mlab-modules/DATALOGGER02/doc/gen/img/DATALOGGER02-bottom.png

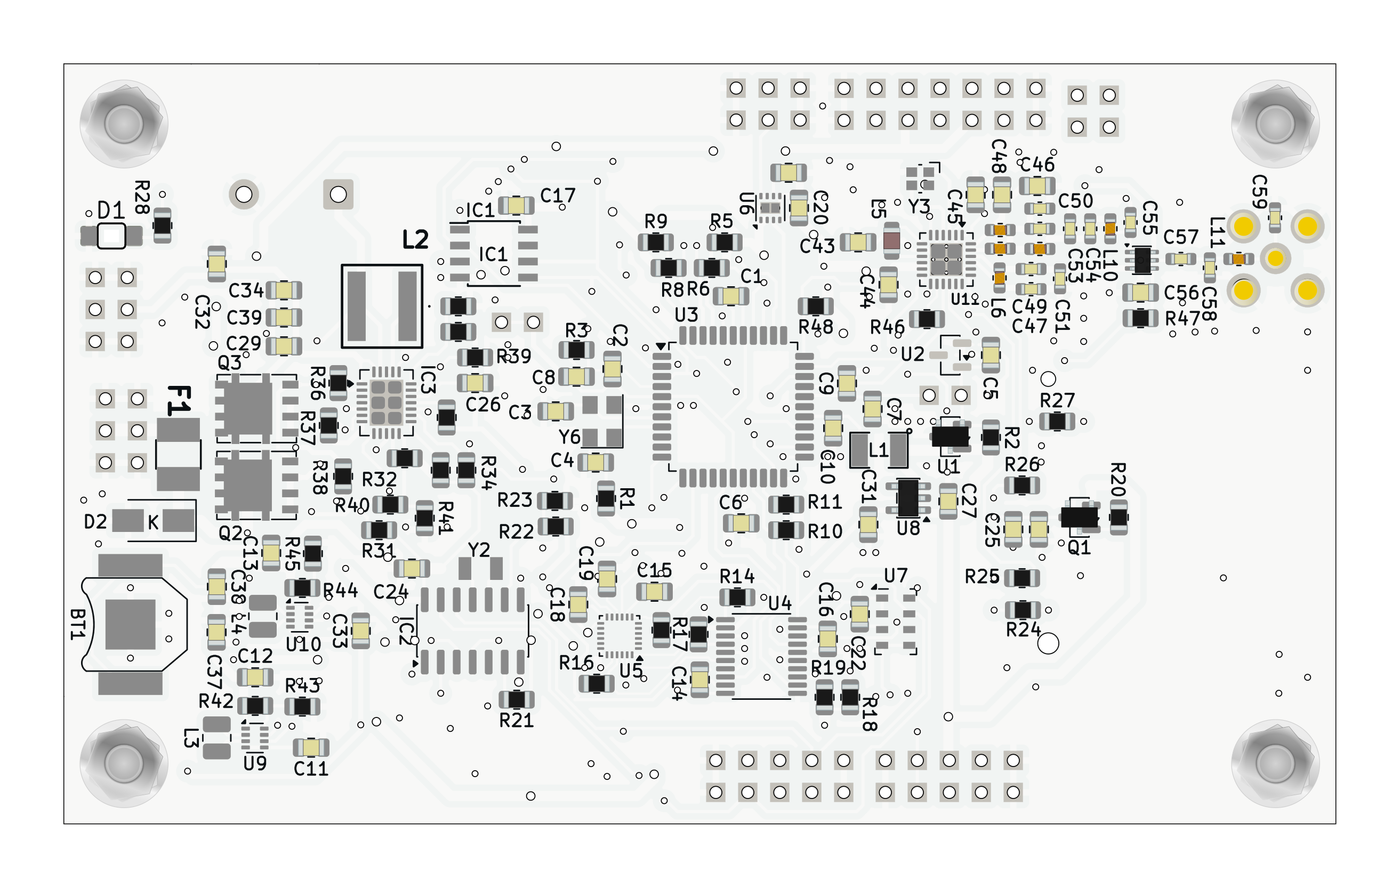
doc/gen/img/DATALOGGER02-bottom.png
