mlab-modules/DATALOGGER02/doc/gen/img/DATALOGGER02-top.png

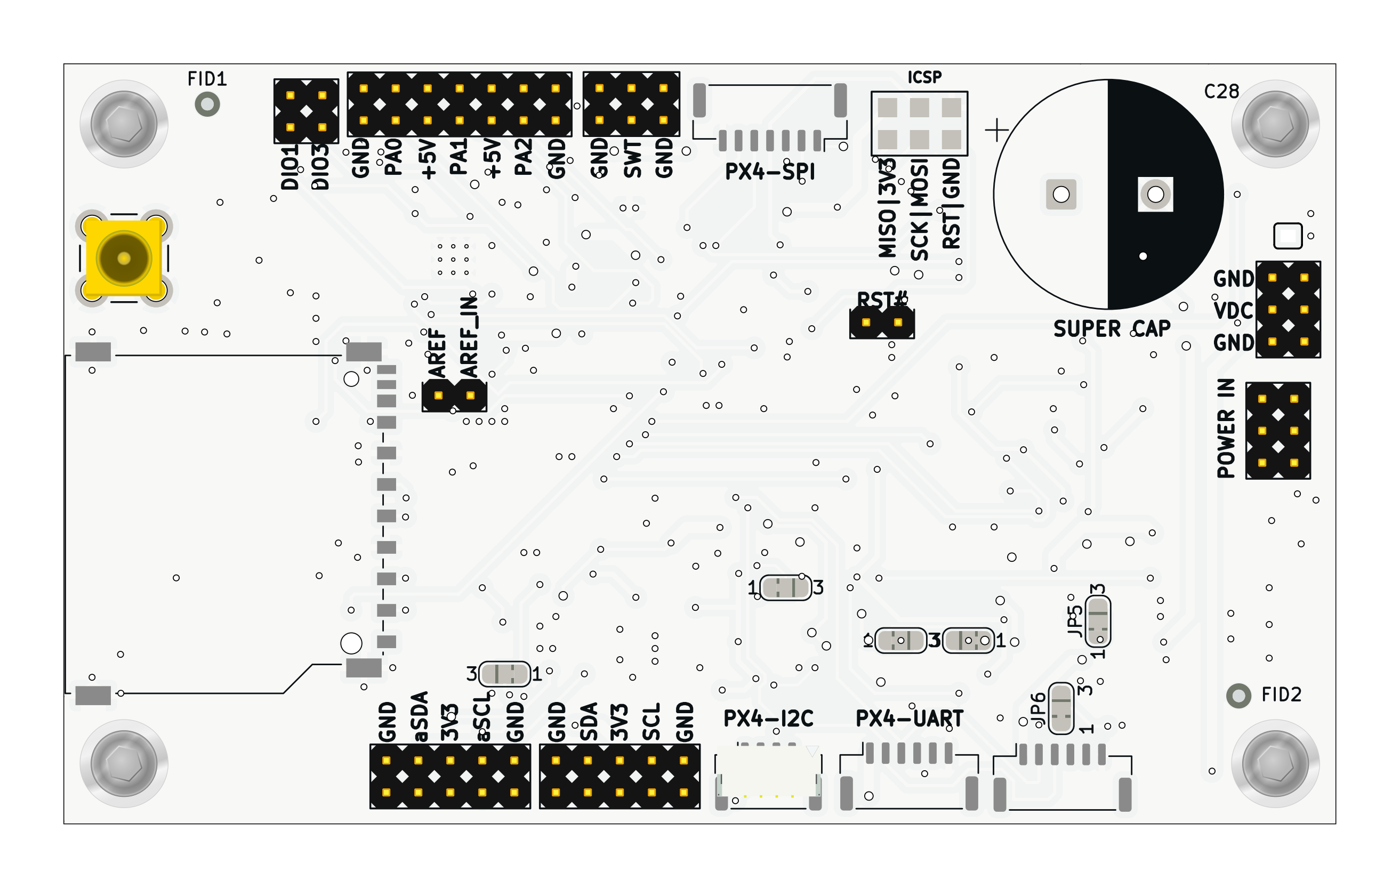
doc/gen/img/DATALOGGER02-top.png
