mlab-modules/DATALOGGER02/doc/gen/DATALOGGER02.step

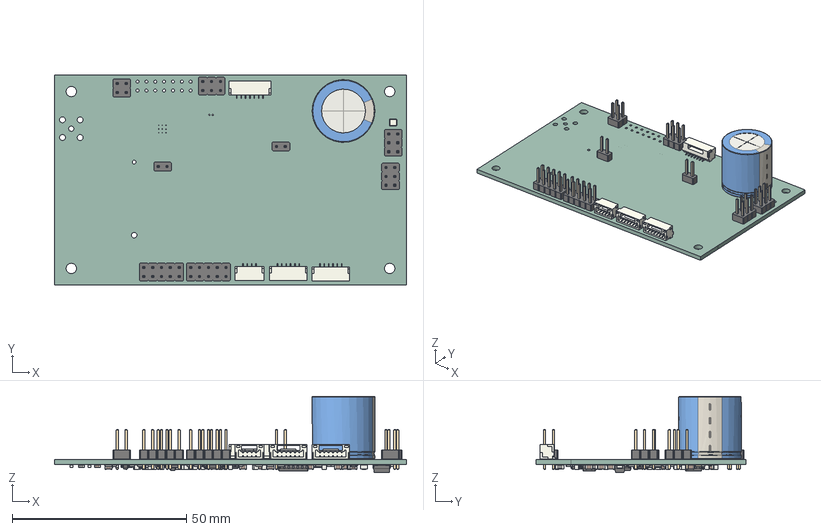
[picture p3: CAD file, 2026-08-09]
doc/gen/DATALOGGER02.step
101.1 x 60.5 x 21.9 mm
PinHeader_2x03_P254mm_Vertical x 3
PinHeader_2x05_P254mm_Vertical x 2
CP_Radial_D180mm_P750mm
JST_SM04B_GHS_TB
JST_SM06B_GHS_TB x 2
PinHeader_2x01_P254mm_Vertical x 2
PinHeader_2x02_P254mm_Vertical
JST_SM07B_GHS_TB
R_0805_2012Metric x 44
C_0805_2012Metric x 41
SOIC-14_3.9x8.7mm_P1.27mm
C_0603_1608Metric x 11
L_0603_1608Metric x 6
QFN-24-1EP_4x4mm_Pitch0.5mm
SOT-363_SC-70-6
SOT-583-8 x 2
TSSOP-20_4.4x6.5mm_P0.65mm
SOT-23 x 2
LED_1206_3216Metric
QFN-24-1EP_4x5mm_Pitch0.5mm
SOT-23-5
WSON_8_1EP_2x2mm_P05mm_EP09x16mm
LGA_8_3x5mm_P125mm
L_0805_2012Metric
L_1008_2520Metric x 2
TQFP-44_10x10mm_P0.8mm
SOIC-8_3.9x4.9mm_P1.27mm
D_SMA
kibot_2kaa3o_s_PCB
