mlab-modules/DATALOGGER02/doc/gen/dxf/DATALOGGER02-Edge_Cuts.dxf

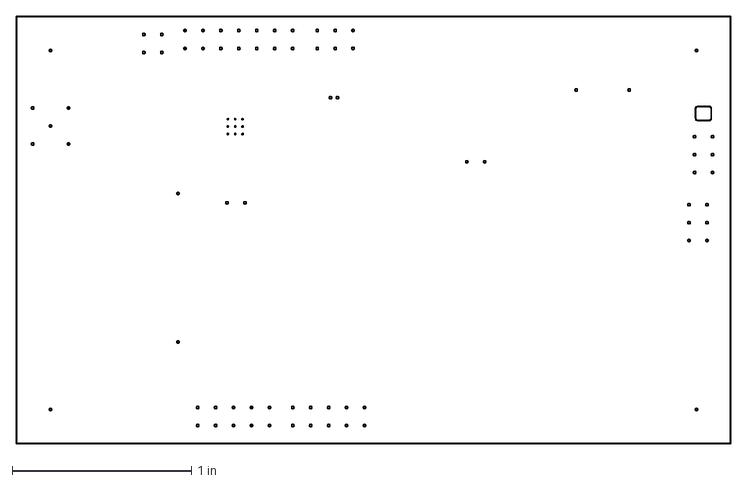
[picture p4: CAD file, 2026-08-09]
doc/gen/dxf/DATALOGGER02-Edge_Cuts.dxf
3.98 x 2.38 in
