mlab-modules/DATALOGGER02/doc/gen/dxf/DATALOGGER02-B_Fab.dxf

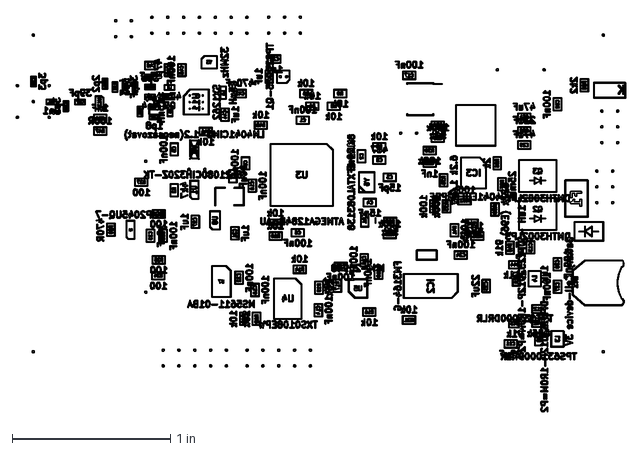
[picture p5: CAD file, 2026-08-09]
doc/gen/dxf/DATALOGGER02-B_Fab.dxf
3.85 x 2.50 in
