mlab-modules/DATALOGGER02/doc/gen/dxf/DATALOGGER02-User_Drawings.dxf

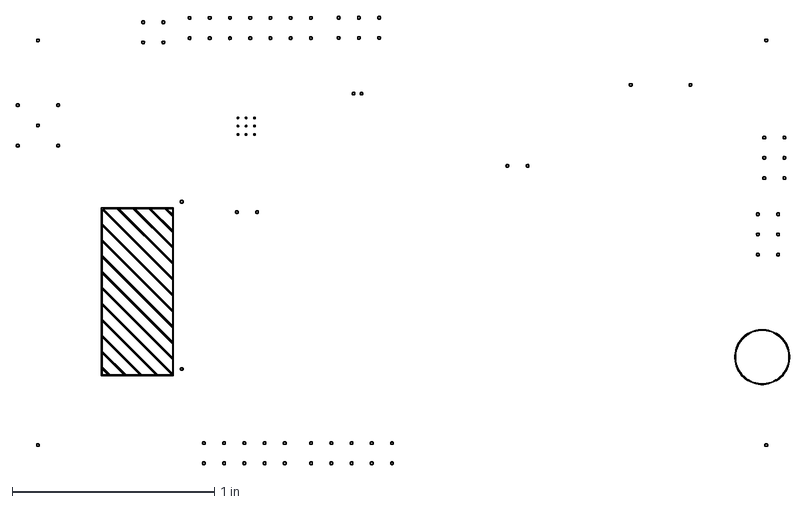
[picture p6: CAD file, 2026-08-09]
doc/gen/dxf/DATALOGGER02-User_Drawings.dxf
3.82 x 2.22 in
