mlab-modules/DATALOGGER02/doc/gen/dxf/DATALOGGER02-F_Courtyard.dxf

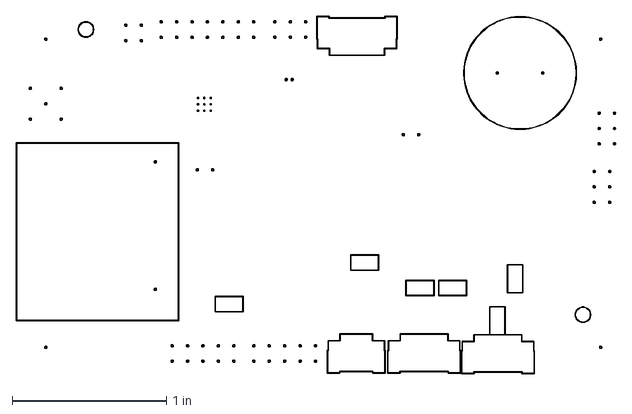
[picture p7: CAD file, 2026-08-09]
doc/gen/dxf/DATALOGGER02-F_Courtyard.dxf
3.89 x 2.32 in
