mlab-modules/DATALOGGER02/doc/gen/dxf/DATALOGGER02-F_Fab.dxf

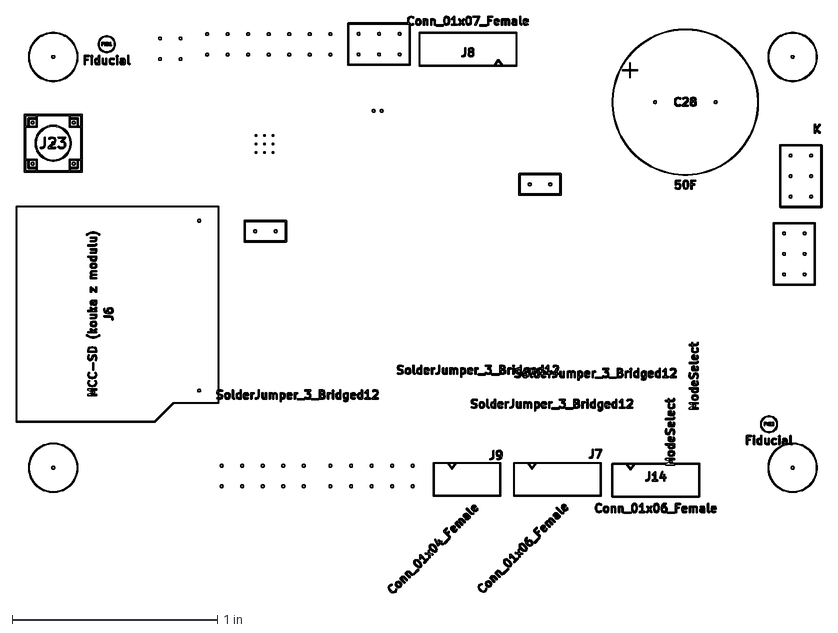
[picture p8: CAD file, 2026-08-09]
doc/gen/dxf/DATALOGGER02-F_Fab.dxf
3.92 x 2.81 in
