mlab-modules/DATALOGGER02/doc/gen/dxf/DATALOGGER02-B_Adhesive.dxf

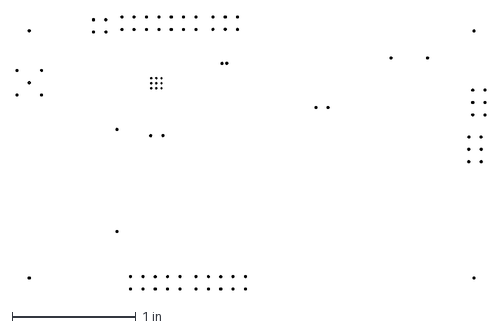
[picture p9: CAD file, 2026-08-09]
doc/gen/dxf/DATALOGGER02-B_Adhesive.dxf
3.80 x 2.22 in
