mlab-modules/DATALOGGER02/doc/gen/dxf/DATALOGGER02-User_Comments.dxf

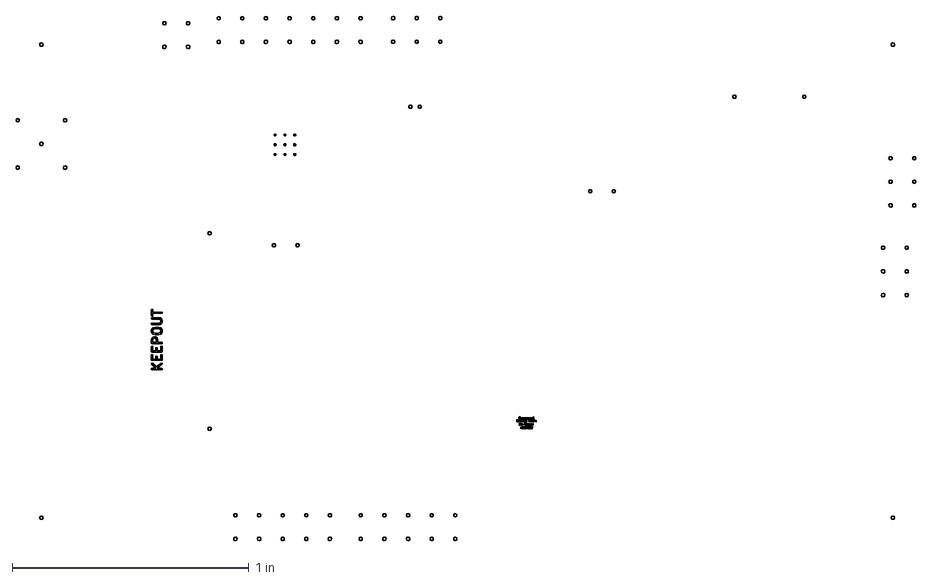
[picture p10: CAD file, 2026-08-09]
doc/gen/dxf/DATALOGGER02-User_Comments.dxf
3.80 x 2.22 in
