mlab-modules/DATALOGGER02/doc/gen/dxf/DATALOGGER02-Margin.dxf

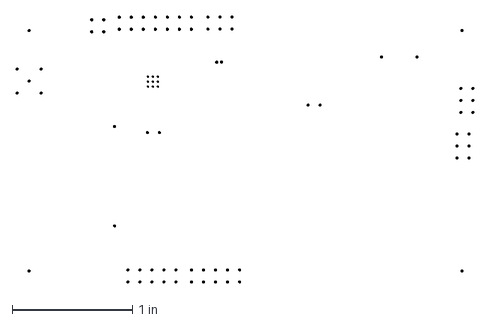
[picture p11: CAD file, 2026-08-09]
doc/gen/dxf/DATALOGGER02-Margin.dxf
3.80 x 2.22 in
