mlab-modules/DATALOGGER02/doc/gen/dxf/DATALOGGER02-B_Courtyard.dxf

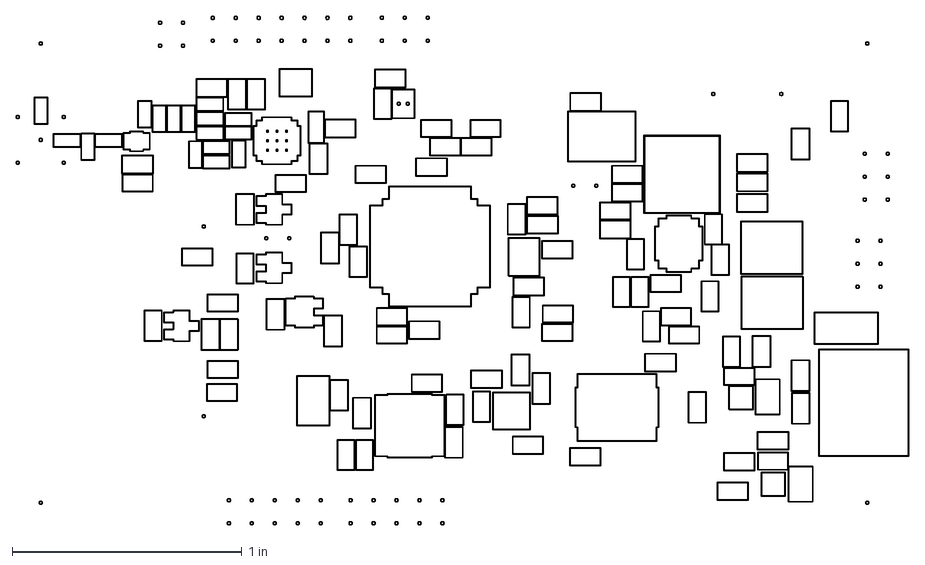
[picture p13: CAD file, 2026-08-09]
doc/gen/dxf/DATALOGGER02-B_Courtyard.dxf
3.89 x 2.22 in
