mlab-modules/DATALOGGER02/doc/gen/dxf/DATALOGGER02-F_Cu.dxf

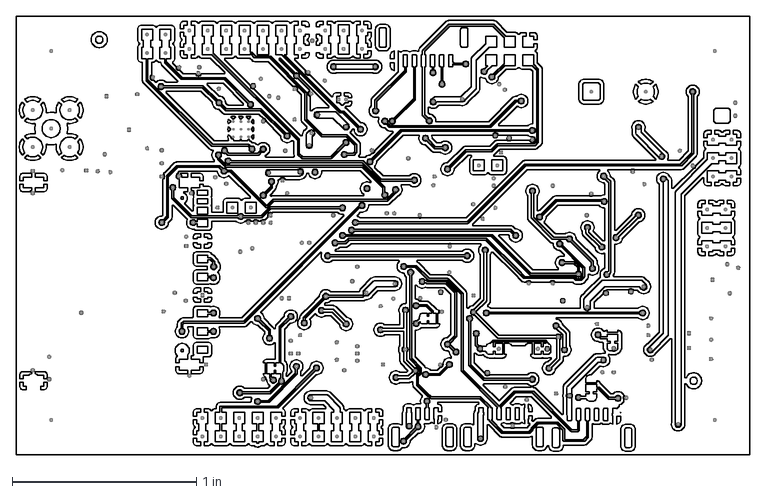
[picture p14: CAD file, 2026-08-09]
doc/gen/dxf/DATALOGGER02-F_Cu.dxf
3.98 x 2.38 in
