mlab-modules/DATALOGGER02/(threads)

Thread 3 (2022-12-24):

Balloon tracker application - DATALOGGER02

kaklik, 2022-12-24:
Modul datalogeru byl již několikrát použit na balonových letech v kombinaci s moduly [GPS02](https://github.com/mlab-modules/GPS02), [ALTIMET](https://github.com/mlab-modules/ALTIMET01) a [ISM02B](https://github.com/mlab-modules/ISM02) LoRa.

Ukazuje se, že tato sestava je velmi častá kombinace modulů, která je použita opakovaně. (Např. i v zařízení [GEODOS](https://github.com/UniversalScientificTechnologies/GEODOS01)).  Dává tak smysl funkce těchto modulů sloučit, nebo upravit tak, aby výsledek byl snadněji použitelný a ještě více spolehlivý.

V případě použití na balonu by tak nový modul byl doplňkem k systému [TF-ATMON](https://www.thunderfly.cz/tf-atmon.html), který by stále sloužil jako hlavní kanál pro přenos telemetrie v reálném čase přes [433 MHz SIK modem](https://github.com/ThunderFly-aerospace/TFSIK01). Nové zařízení by pak mělo primární funkci sekundárního LoRa trackeru sloužícímu ke spolehlivému dohledání.

Kromě těchto dvou vysílačů (LoRa a SiK) by byl stále zachován ještě záložní CW morse maják s nízkým výkonem na 433MHz a samostatným napájením, který umožní dohledání při úplném selhání předchozích dvou systémů, nebo při výpadku navigace.

Nový DATALOGGER02A by tak měl splňovat tyto požadavky:

- Asi stále zachovat architekturu založenou na ATmega (pokud stále jdou sehnat) i když k ní existuje mnoho výhrad  viz mlab-modules/DATALOGGER01#4
   -  Je ale potřeba nějak vyřešit problém s napájecím napětím verzus frekvence MCU mlab-modules/DATALOGGER01#7
- Zachovat montáž na MLAB desku (aby to šlo snadno používat při experimentech s dalšími moduly)
- Snížit rozměry oproti původnímu velkému PCB DATALOGGER01
- Předpokládat napájení z jednoho externě připojeného článku velikosti 18650 (48g) místo původní dvojice LS33600 (90g každá), tohle rovnou vyřeší problém mlab-modules/DATALOGGER01#8, například z modulu [LION1CELL](https://github.com/mlab-modules/LION1CELL01).
- Jako zdroj polohy předpokládat připojení [TFGPS](https://github.com/ThunderFly-aerospace/TFGPS01), která bude připojená přes _Autopilot GPS&SAFETY_ konektor
   - Umožnit napájení pro GPS selektivně řízeně vypnout z firmware. Nejspíš stejným způsobem jako napájení SDkarty.
- Přidat teploměr a tlakoměr  [ALTIMET02](https://github.com/mlab-modules/ALTIMET02) na jeden PCB.
- Přidat celý [LoRa modul](https://github.com/mlab-modules/ISM02)
- Odpojování napájení SDkarty vyřešit lépe mlab-modules/DATALOGGER01#2
   - ~~Možná celou SDkartu nahradit [tímhle](https://learn.adafruit.com/adafruit-spi-flash-sd-card), pokud se ukáže, že je to spolehlivější~~ Nejde to připojit jako SDkarta do čtečky SDkaret.
   - Přidat [FRAM](https://github.com/mlab-modules/FRAM01) pro spolehlivé logování malých dat.
- Zvážit výměnu současného RTC za nový obvod mlab-modules/DATALOGGER01#9, který zároveň zajistí jednoznačné sériové číslo měření. Původní RTC obvod byl vybraný tak, aby umožnil udržet poměrně přesný čas přes dlouhé měřené úseky. Nevím ale o tom, že by se to někdy využilo.
- Vznikl také nápad tam přidat IMU, což má opodstatnění pro dektekci volného pádu (prasknutí balonu), nebo detekci toho že to někdo přenáší (krade GEODOS). Víc se s MCU co nyní v datalogeru je asi upočítat nedá. Doteď jsme všude používali [ICM-20948](https://invensense.tdk.com/products/motion-tracking/9-axis/icm-20948/)
- Přidat konektory odpovídající [pixhawk standardu](https://github.com/pixhawk/Pixhawk-Standards/blob/master/DS-009%20Pixhawk%20Connector%20Standard.pdf). (Názvy odpovídají názvům v dokumentu)
   - GPS&SAFETY (s 5V výstupem)
   - UART ty musí být dva typy s různými pinouty
      -  pro připojení směrem k payloadu např [LABDOS](https://github.com/UniversalScientificTechnologies/LABDOS01), který musí být napájen z dataloggeru
      -  pro připojení směrem k autopilotu - zároveň jako způsob napájení dataloggeru z autopilota
   - I2C port (s 5V výstupem napájení a I2C posílené [TCA4307](https://www.ti.com/product/TCA4307))
   - SPI port (taktéž 5V napájení)
 - Přidat pinem vypínatelný měnič na 5V z interního 3.3V napájení, který bude napájet výše zmíněné konektory.

## Možné využití

Takhle upravený dataloger by měl minimálně následující využití

- Tracker stratosférického balonu na LoRa
- Náhrada současné obdobné kombinace modulů v [GEODOSu](https://github.com/UniversalScientificTechnologies/GEODOS01)
- V případě připojení k autopilotovi přes UART by umožnil přenos některých zpráv přes LoRa i bez toho, aby autopilot disponoval vyvedenou SPI sběrnicí. Což by třeba v případě balonu, nebo obecně použití s TF-ATMONem umožnilo používat menší Pixhawk autopiloty.
-
