mlab-modules/DATALOGGER02/doc/gen/DATALOGGER02-schematic.pdf

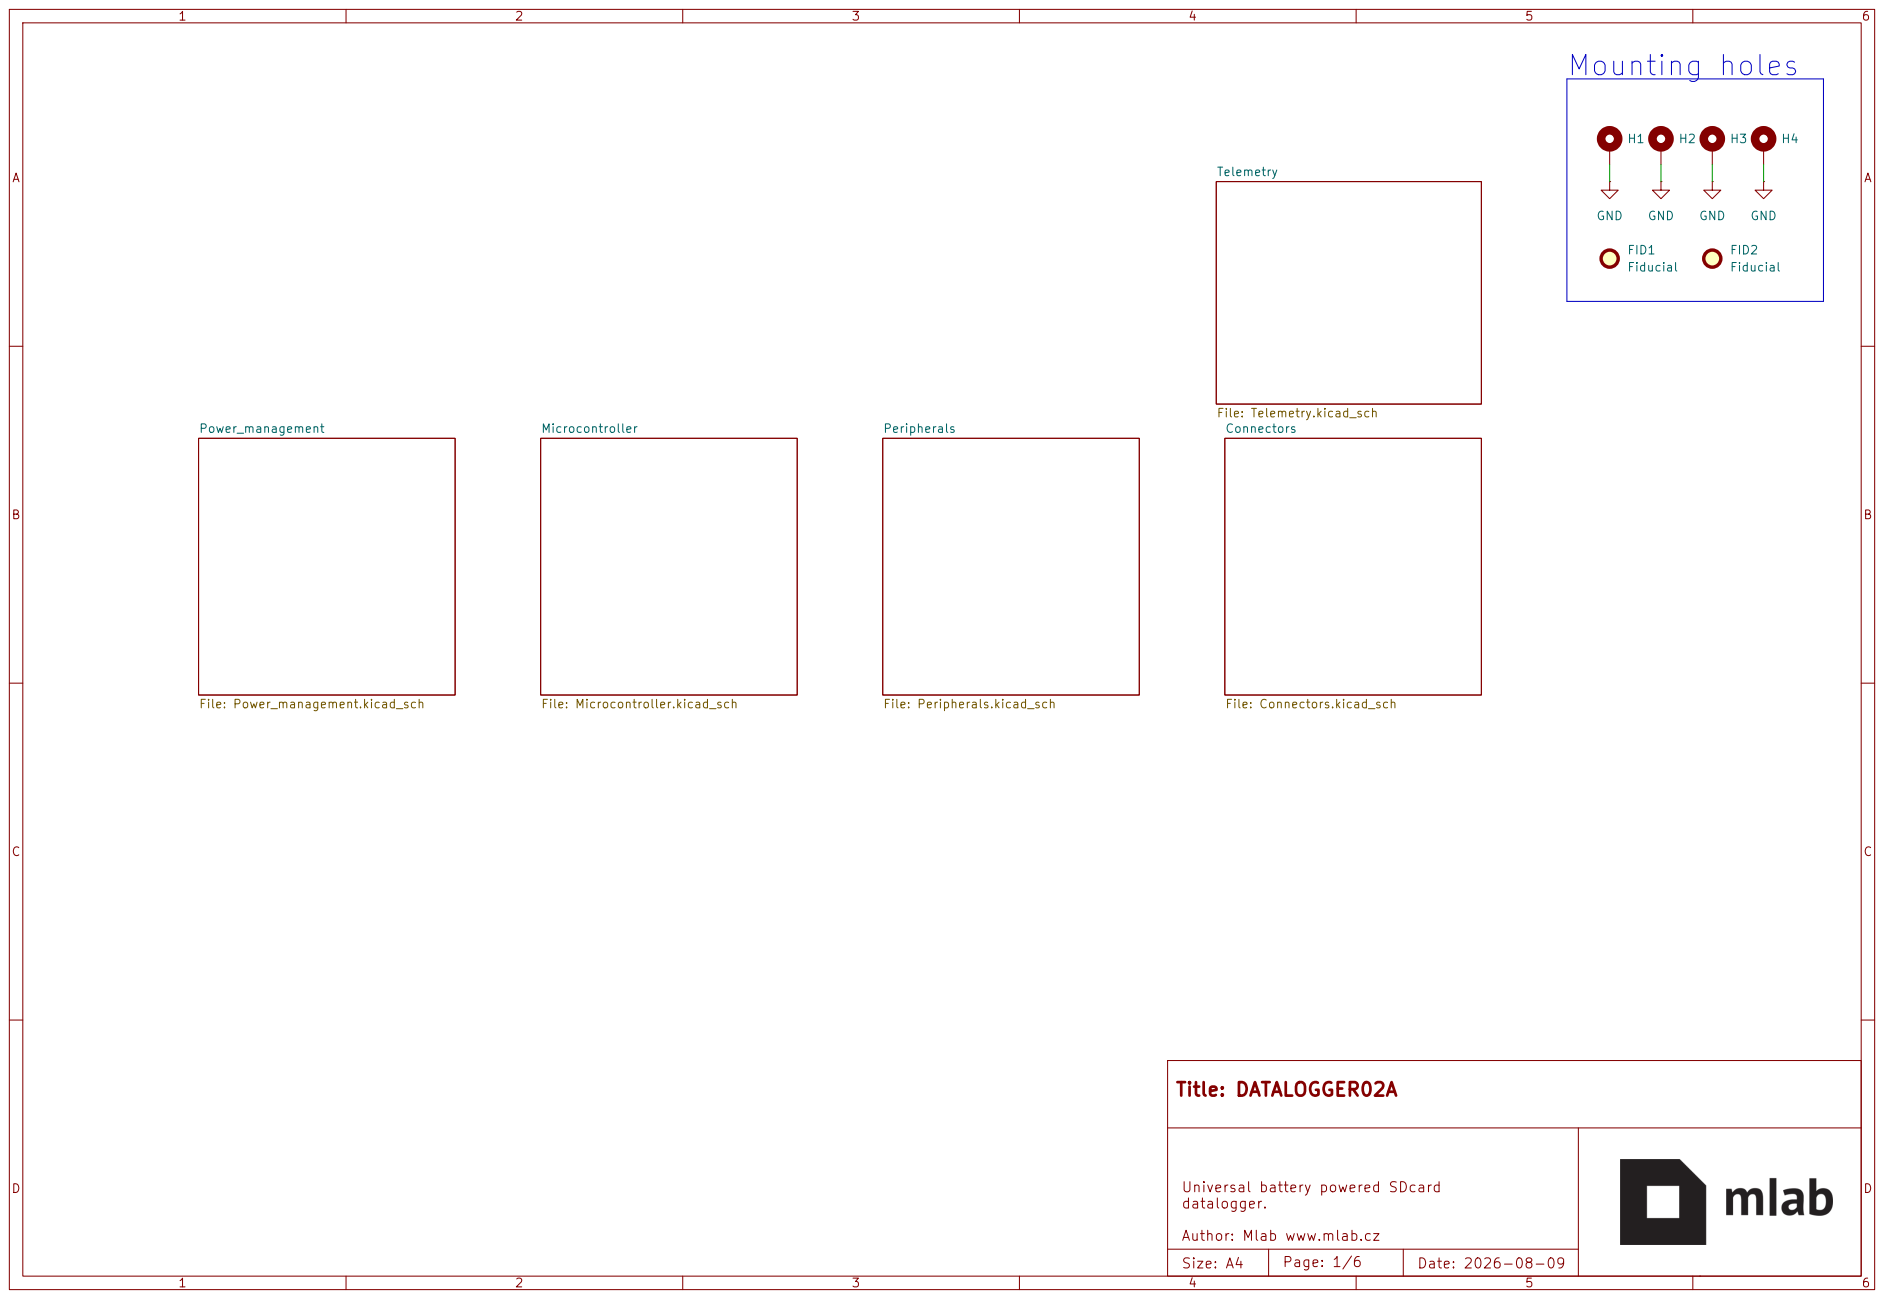
[picture p15: page 1]

Universal battery powered SDcard datalogger. Author: Mlab www.mlab.cz

Size: A4 | Page: 1/6 | Date: 2026-08-09

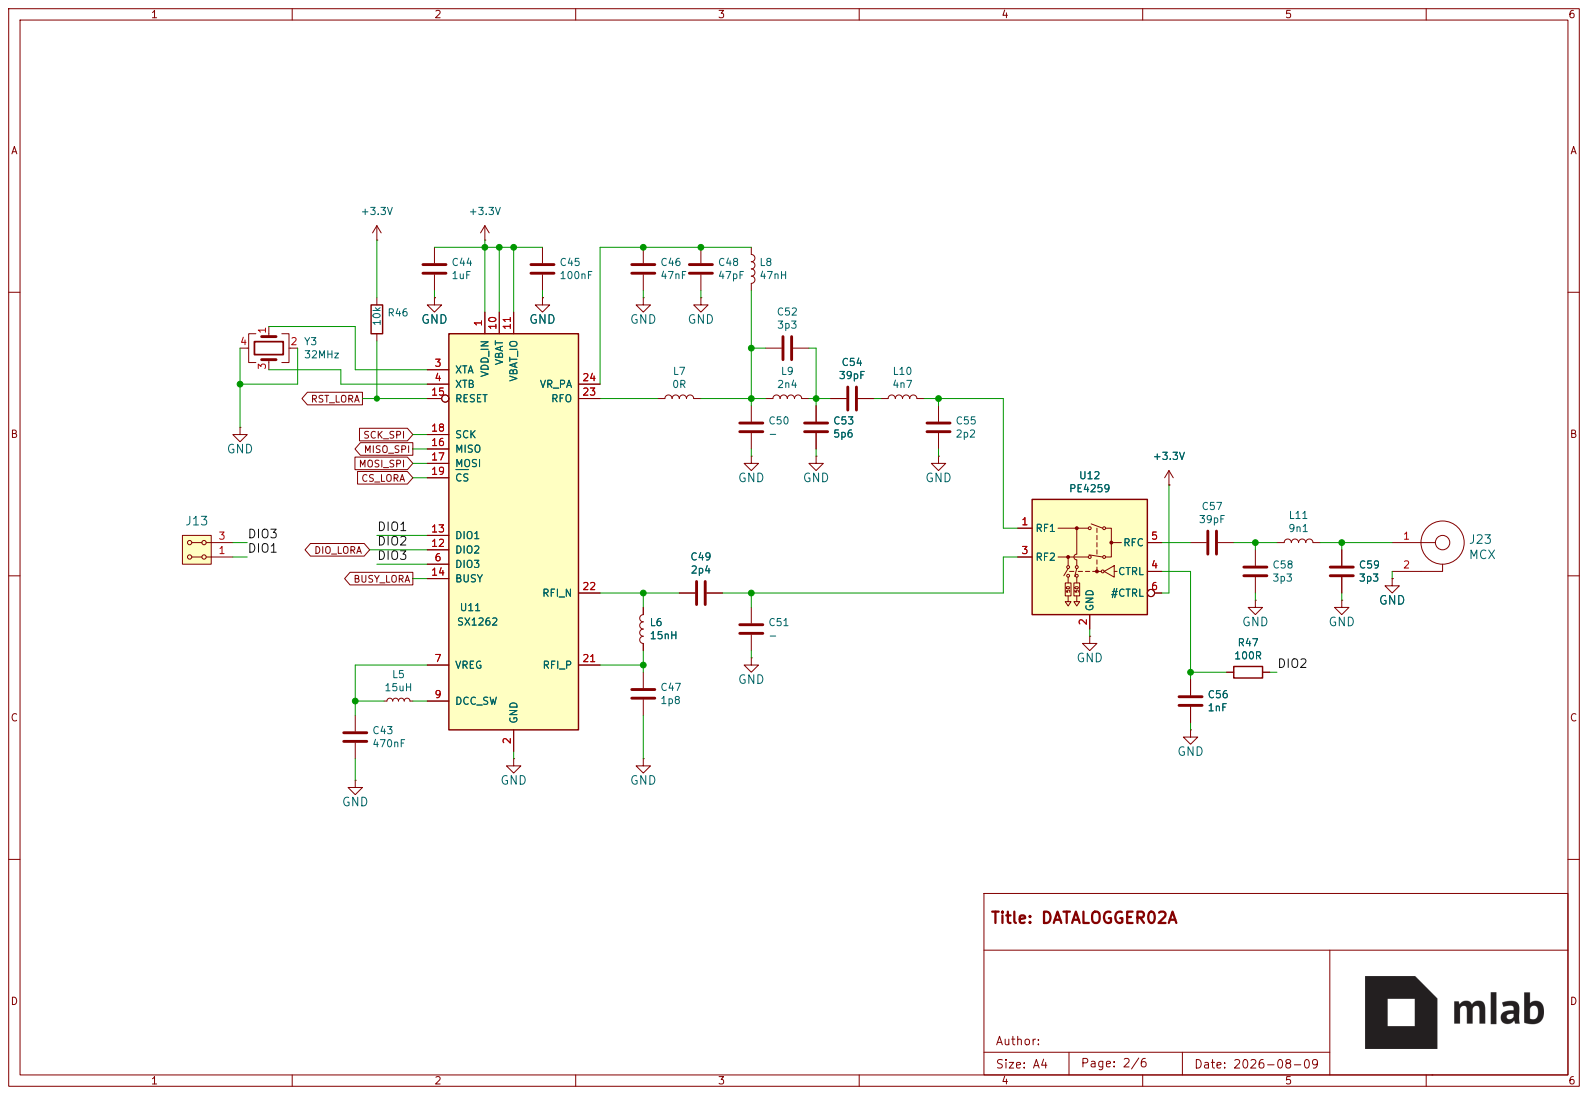
[picture p16: page 2]

2 RF2 3 CTRL 4 RFC 5 #CTRL 6 GND GND

2 RF2 3 CTRL 4 RFC 5 #CTRL 6 U12 PE4259 GND

Author:
Size: A4 | Page: 2/6 | Date: 2026-08-09

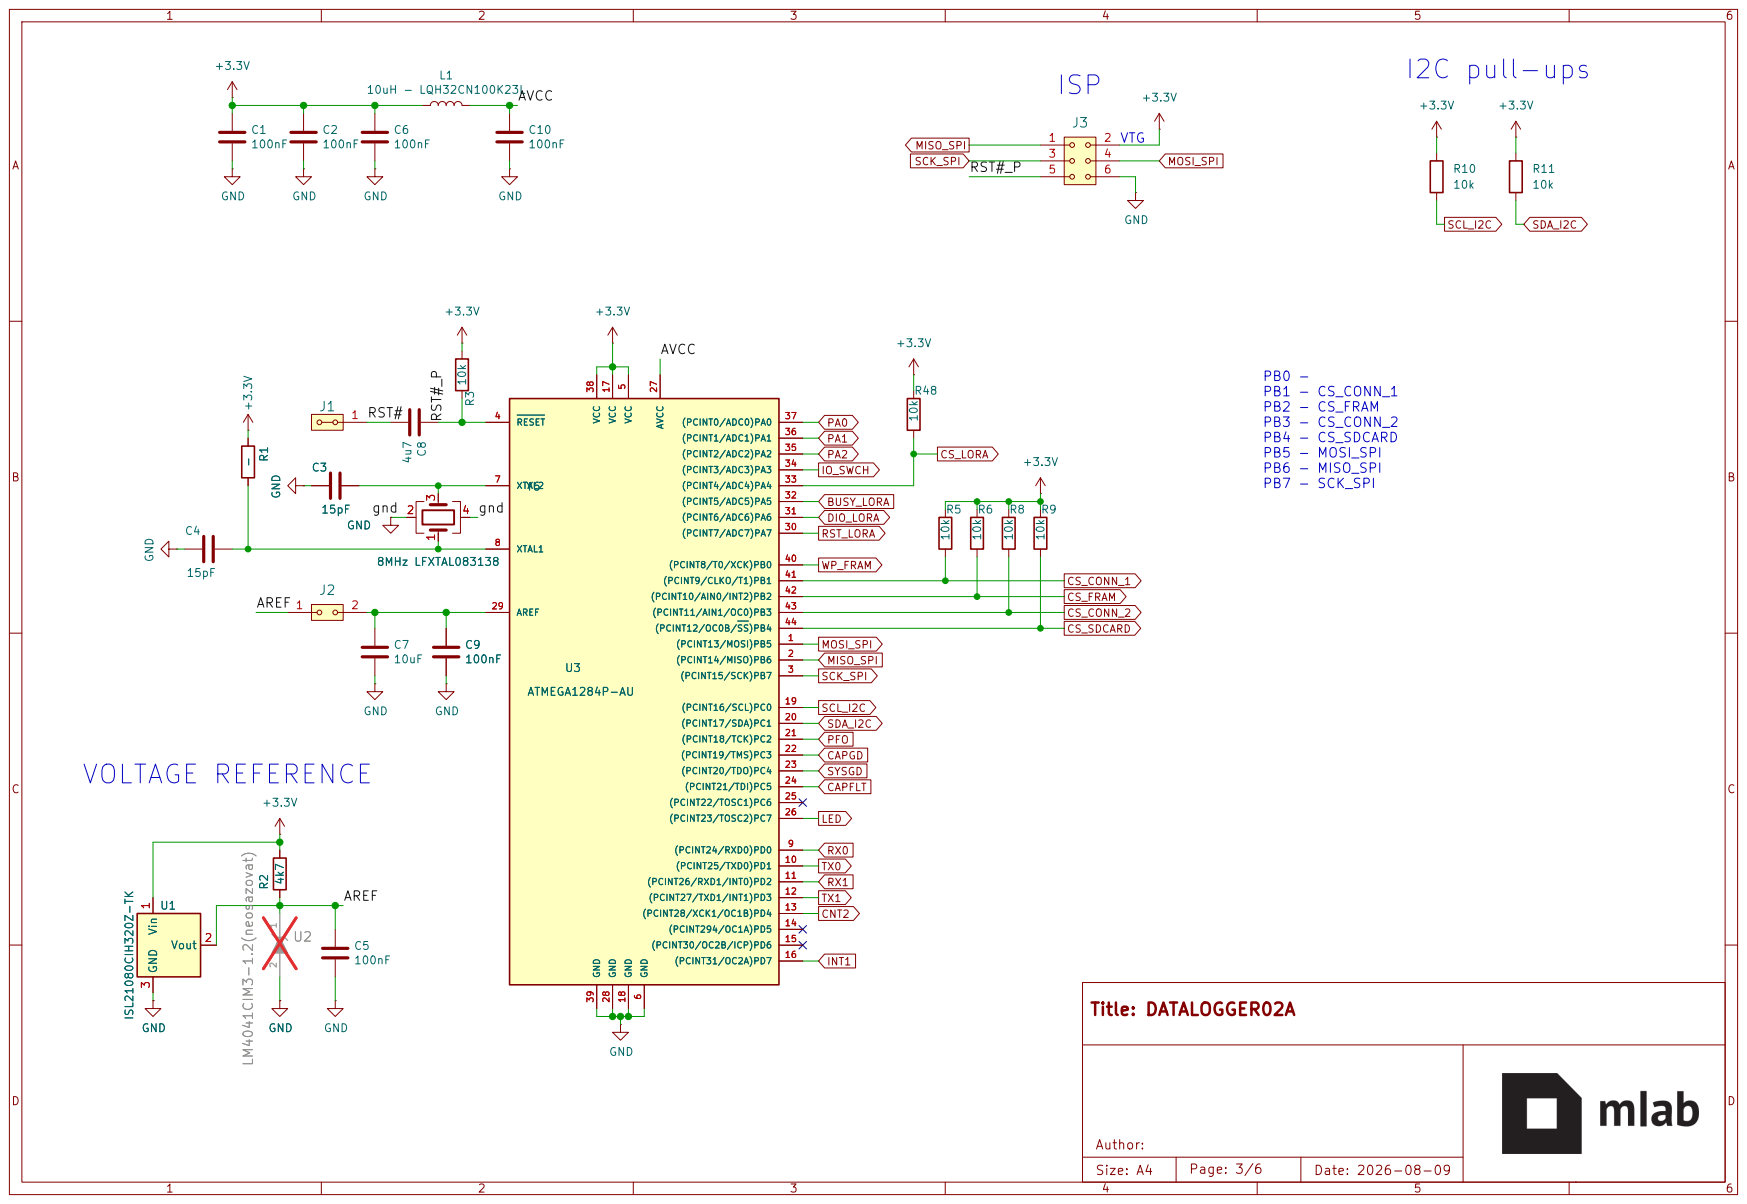
[picture p17: page 3]

Author:
Size: A4 | Page: 3/6 | Date: 2026-08-09

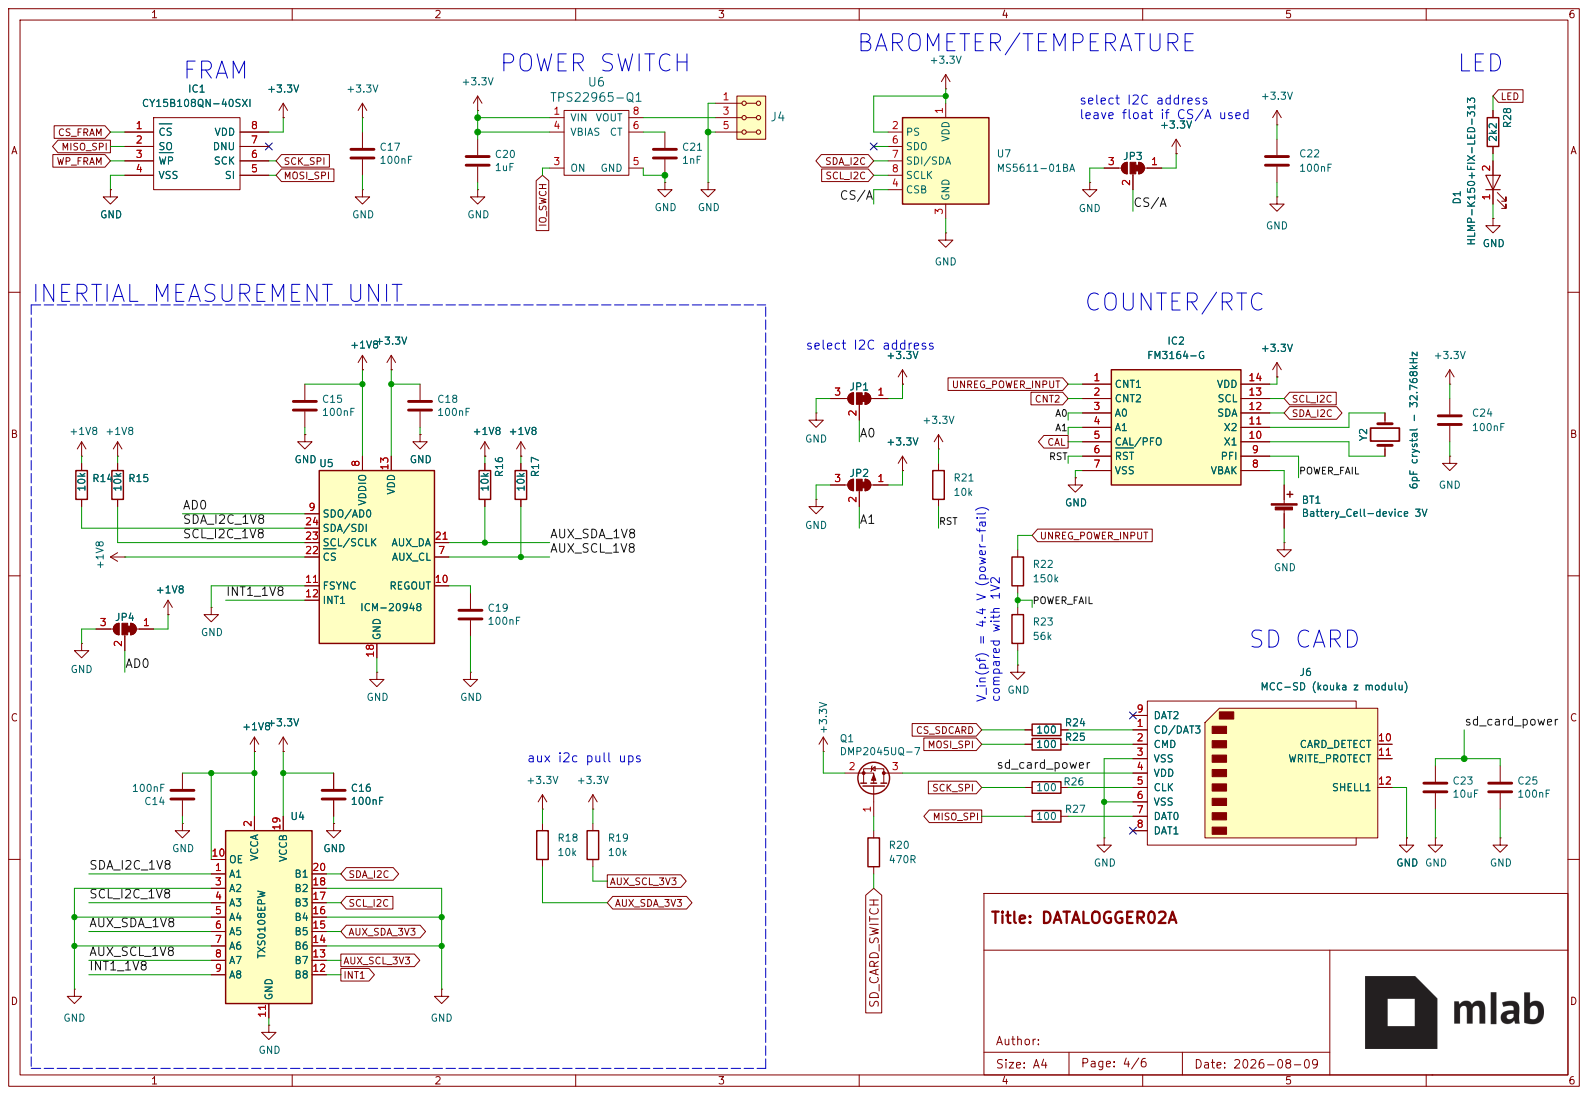
[picture p18: page 4]

BAROMETER/TEMPERATURE
leave float if CS/A used V_in(pf) = 4.4 V (power-fail) compared with 1V2

AUX_DA 21 CS 22 SCL/SCLK 23 SDA/SDI 24U5

AUX_DA 21 CS 22 SCL/SCLK 23 SDA/SDI 24

J6 MCC-SD (kouka z modulu)

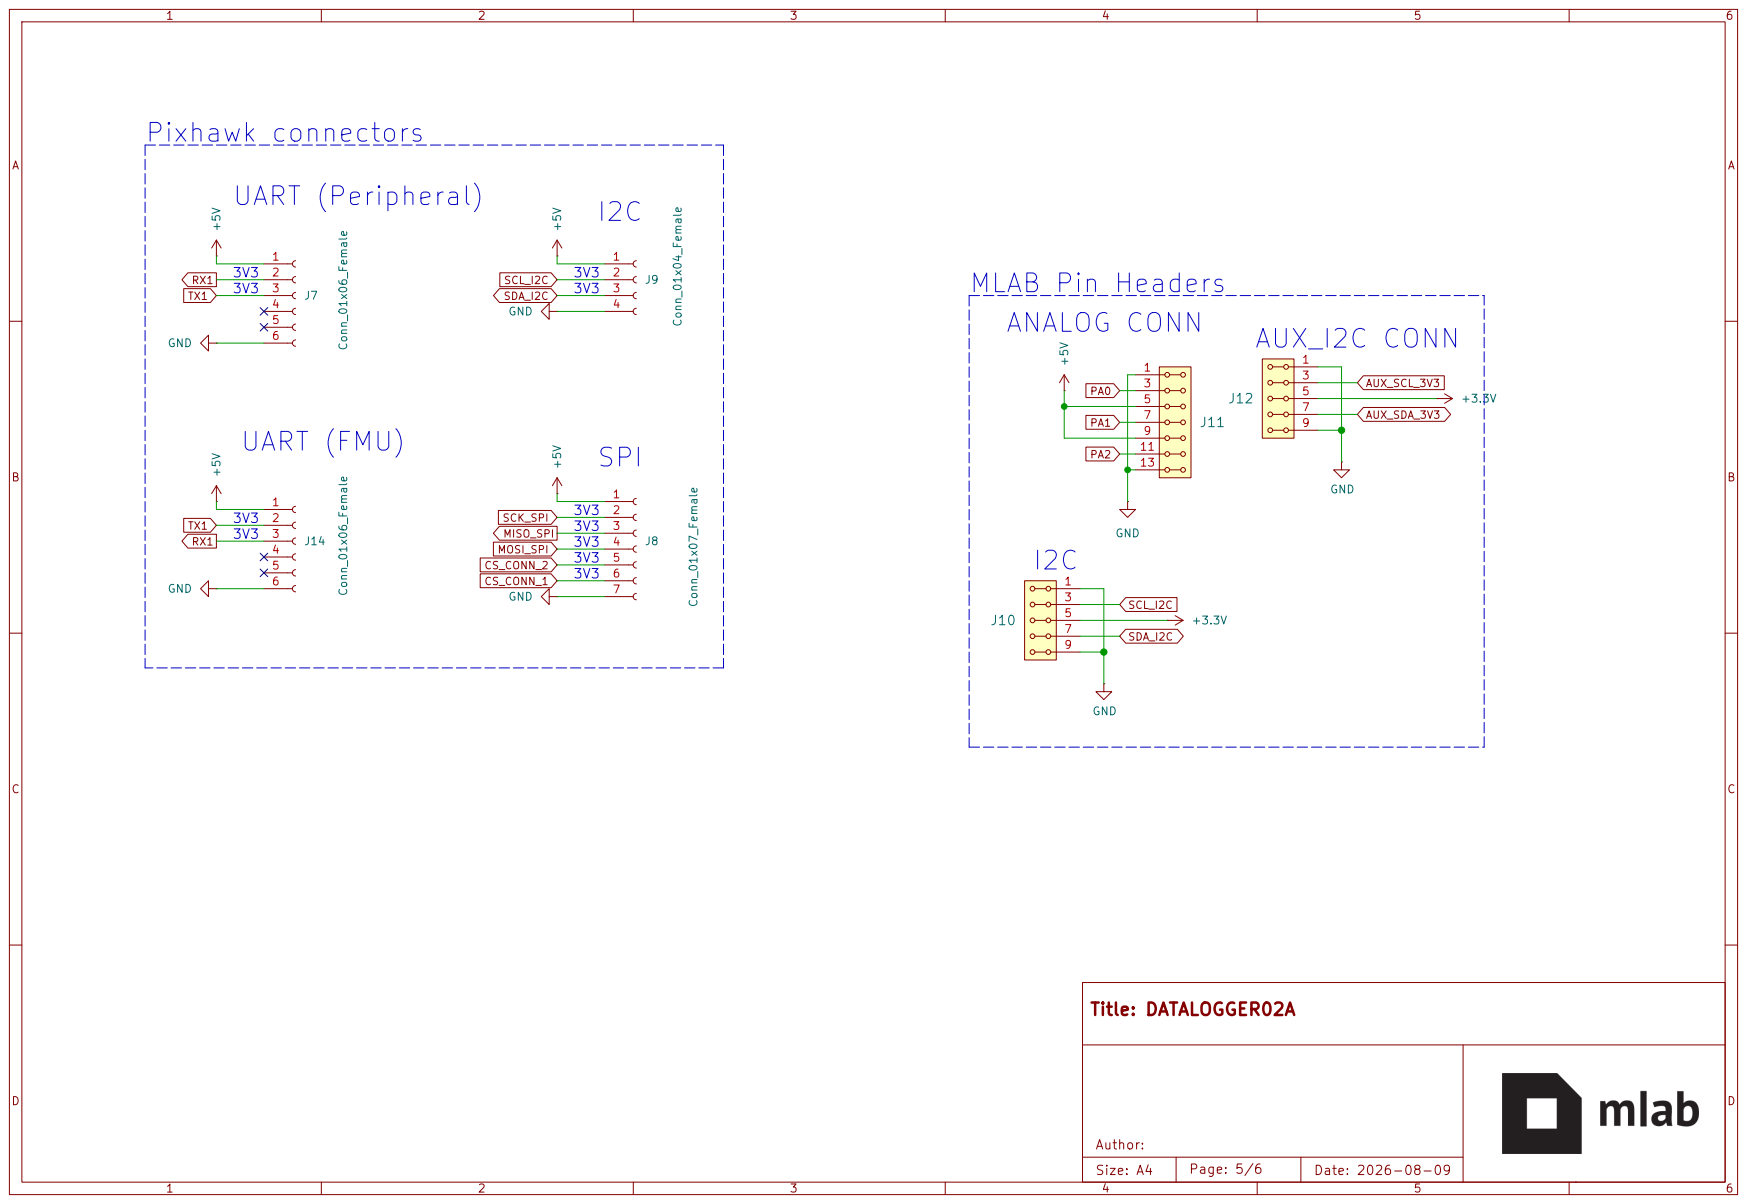
[picture p19: page 5]

Author:
Size: A4 | Page: 5/6 | Date: 2026-08-09

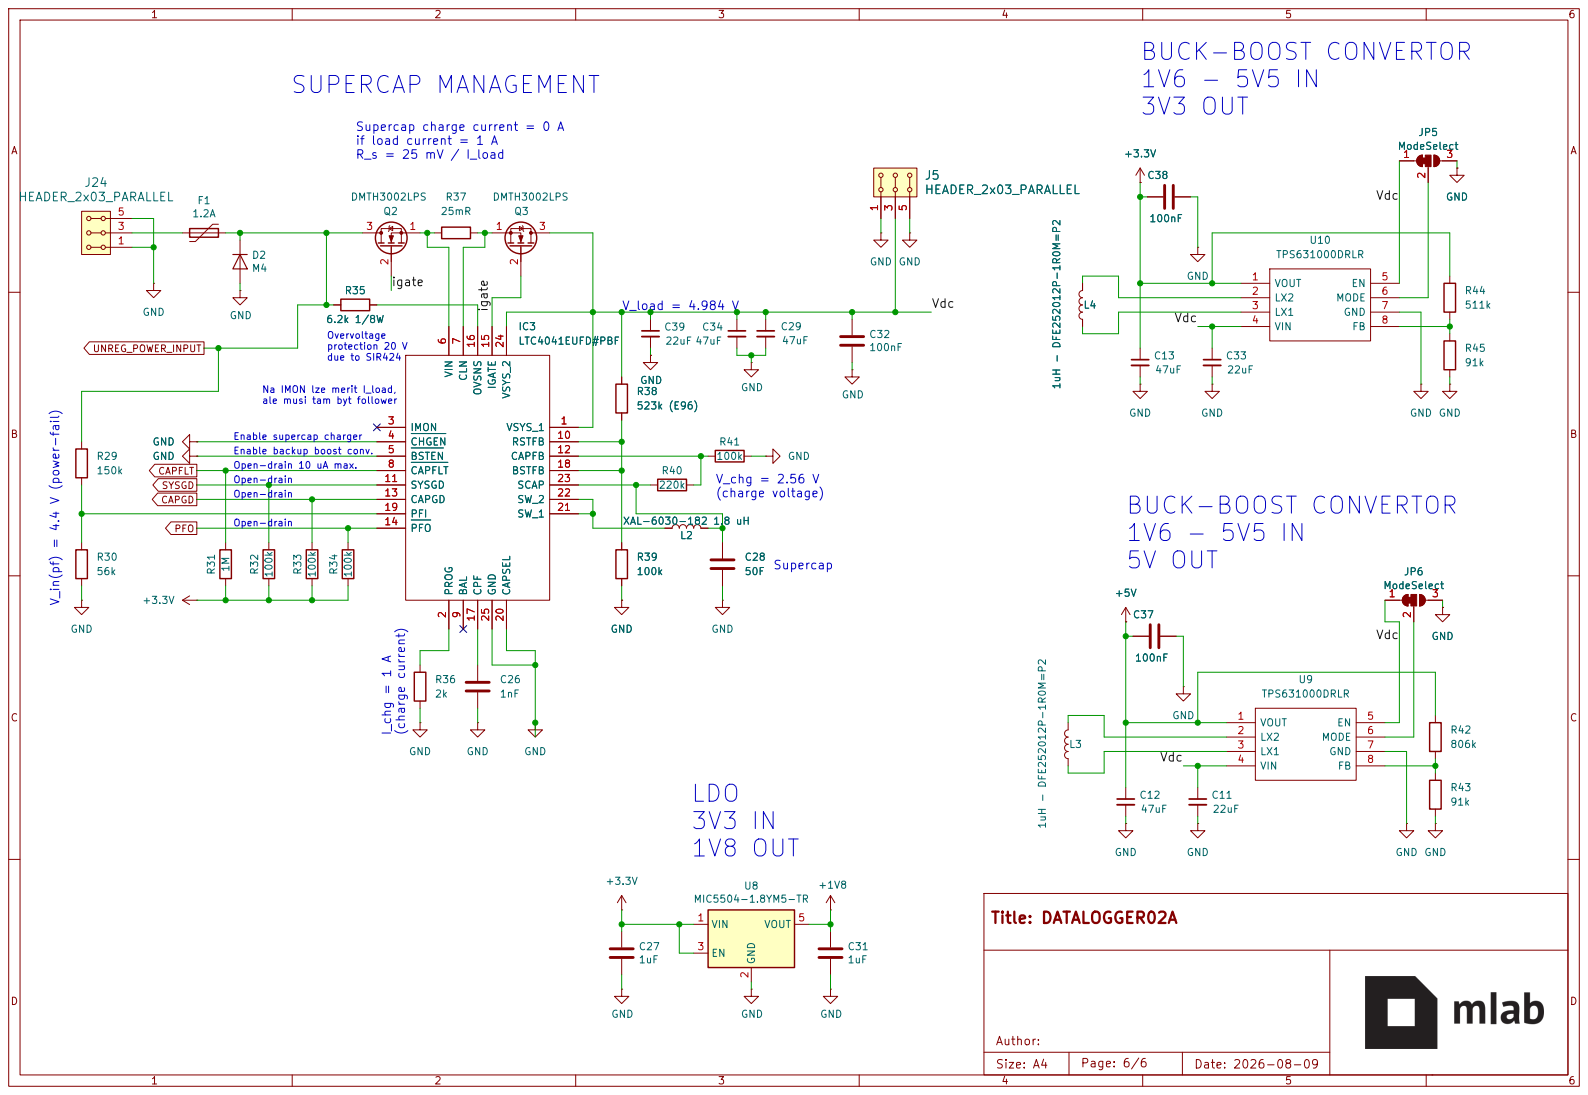
[picture p20: page 6]

Enable backup boost conv. Overvoltage
protection 20 V due to SIR424 Na IMON lze merit I_load, ale musi tam byt follower Enable supercap charger

1V8 OUT V_in(pf) = 4.4 V (power-fail)

Author:
Size: A4 | Page: 6/6 | Date: 2026-08-09
