mlab-modules/DATALOGGER02/hw/cam_profi/assembly/DATALOGGER02-B_Fab+Edge_Cuts.pdf

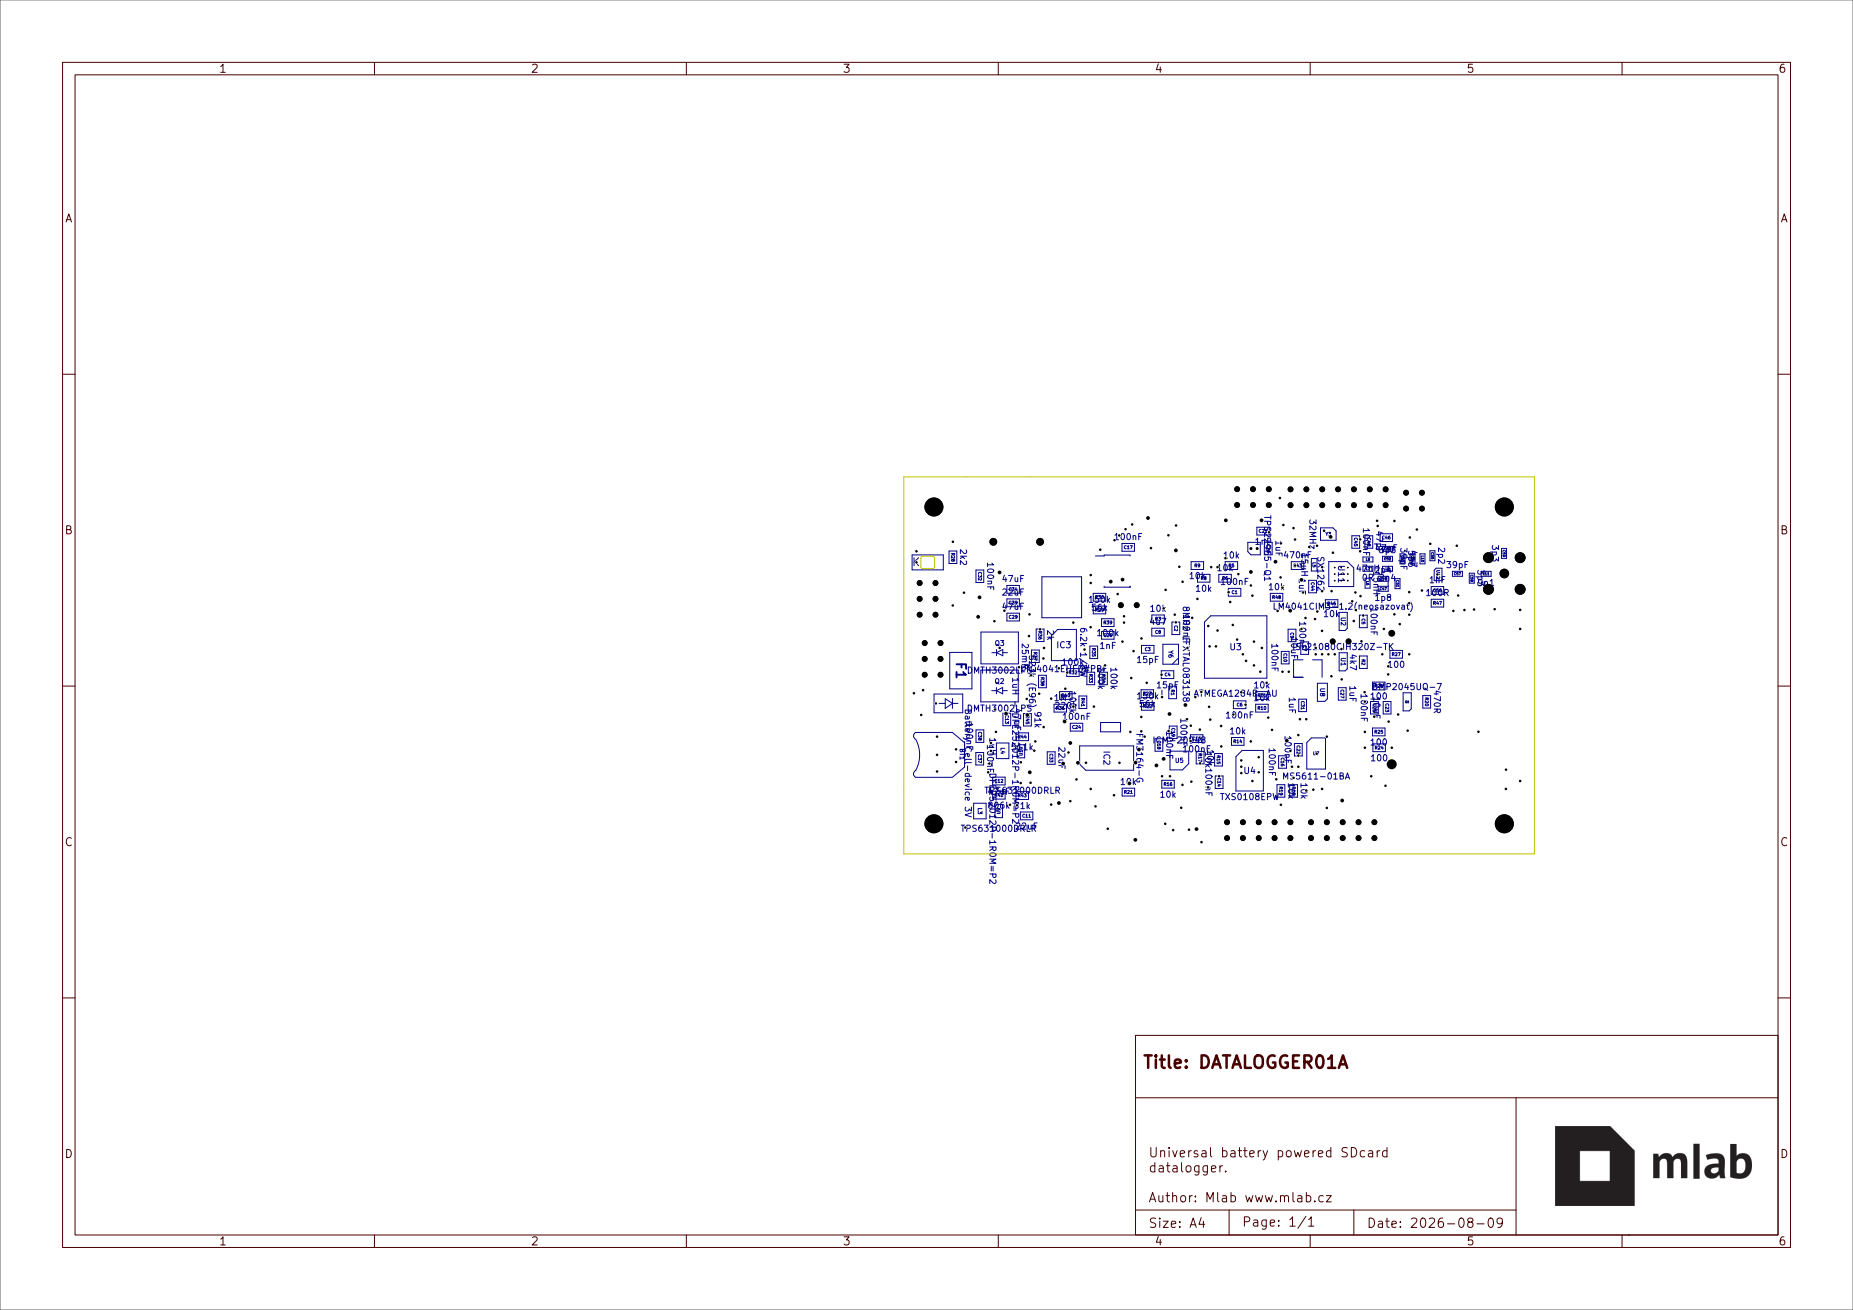
[picture p21: page 1]
