mlab-modules/DATALOGGER02/hw/cam_profi/assembly/DATALOGGER02-F_Fab+Edge_Cuts.pdf

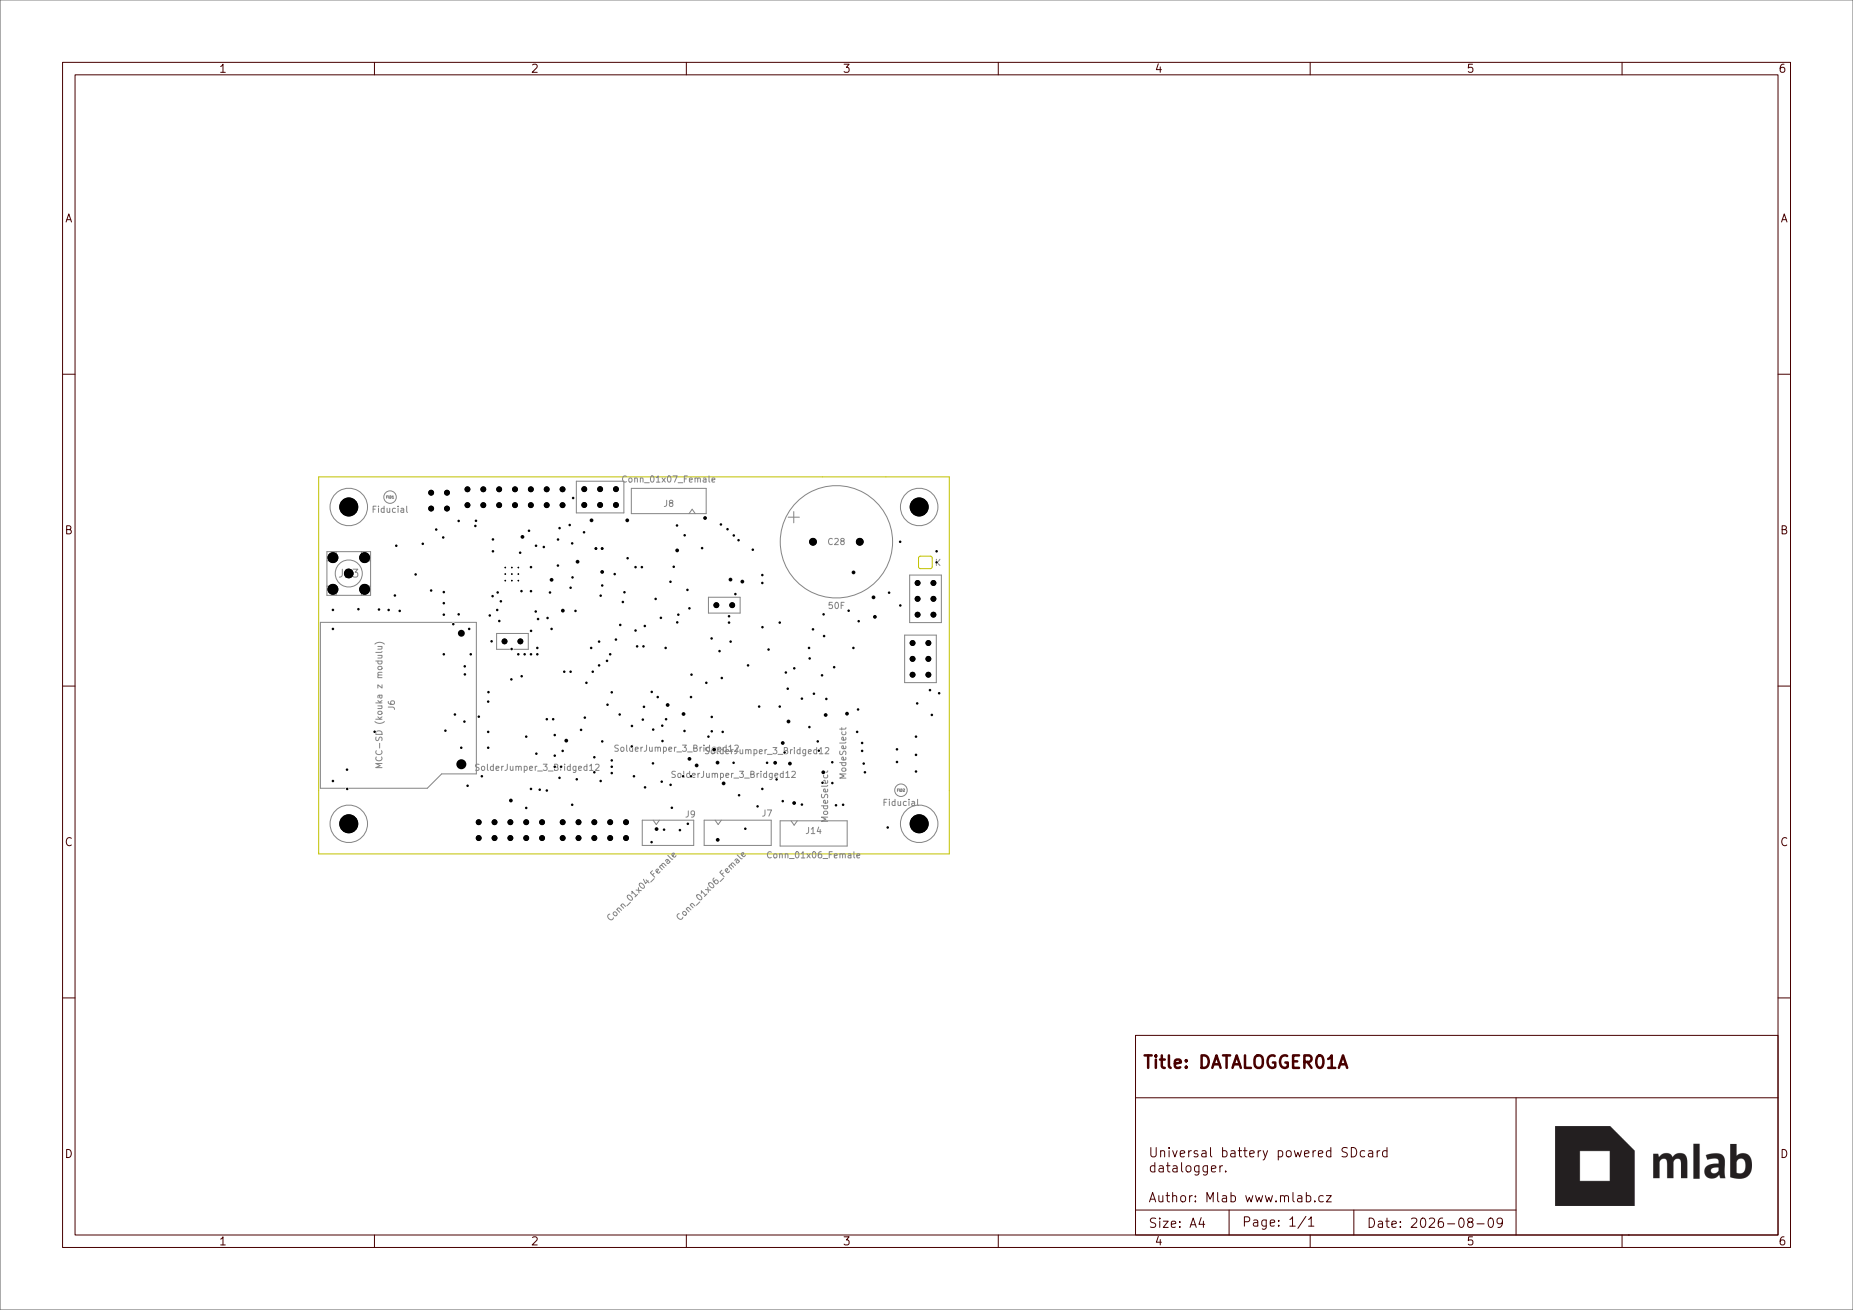
[picture p22: page 1]
