mlab-modules/DATALOGGER02/hw/sch_pcb/DATALOGGER02.kicad_pcb

## KiCad design hw/sch_pcb/DATALOGGER02.kicad_pcb (2026-08-14)

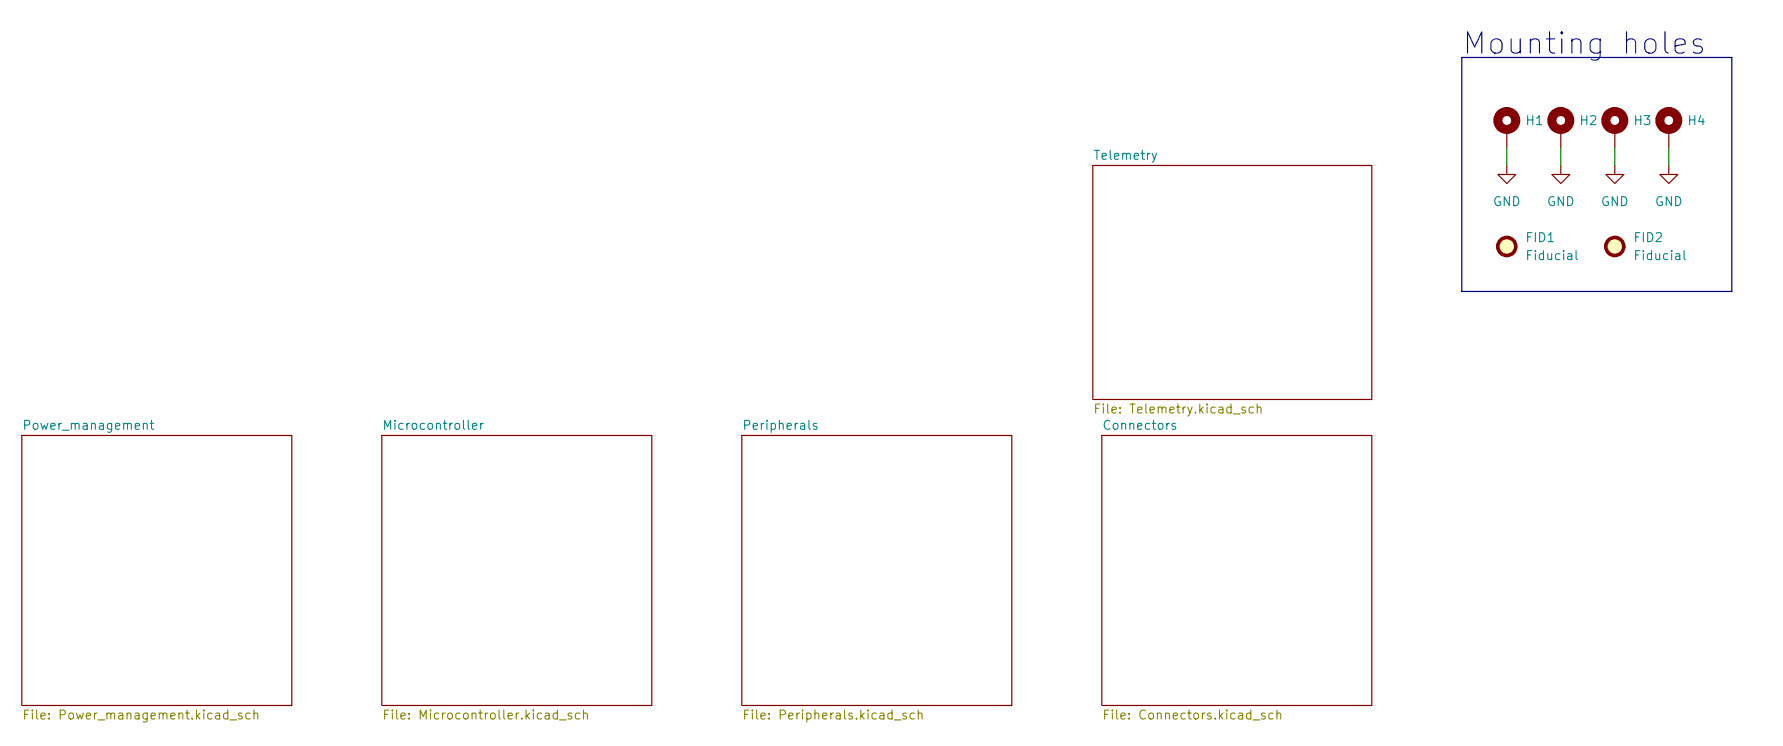
[picture p23: schematic DATALOGGER02.kicad_sch, DATALOGGER02A]

Parts:
FID1, FID2: Fiducial; Fiducial_1mm_Mask2mm
H1, H2, H3, H4: MountingHole_Pad; MountingHole_3mm

Connections:
GND: H1.1 (1_1), H2.1 (1_1), H3.1 (1_1), H4.1 (1_1); also elsewhere on the board

Notes on the sheet:
Mounting holes

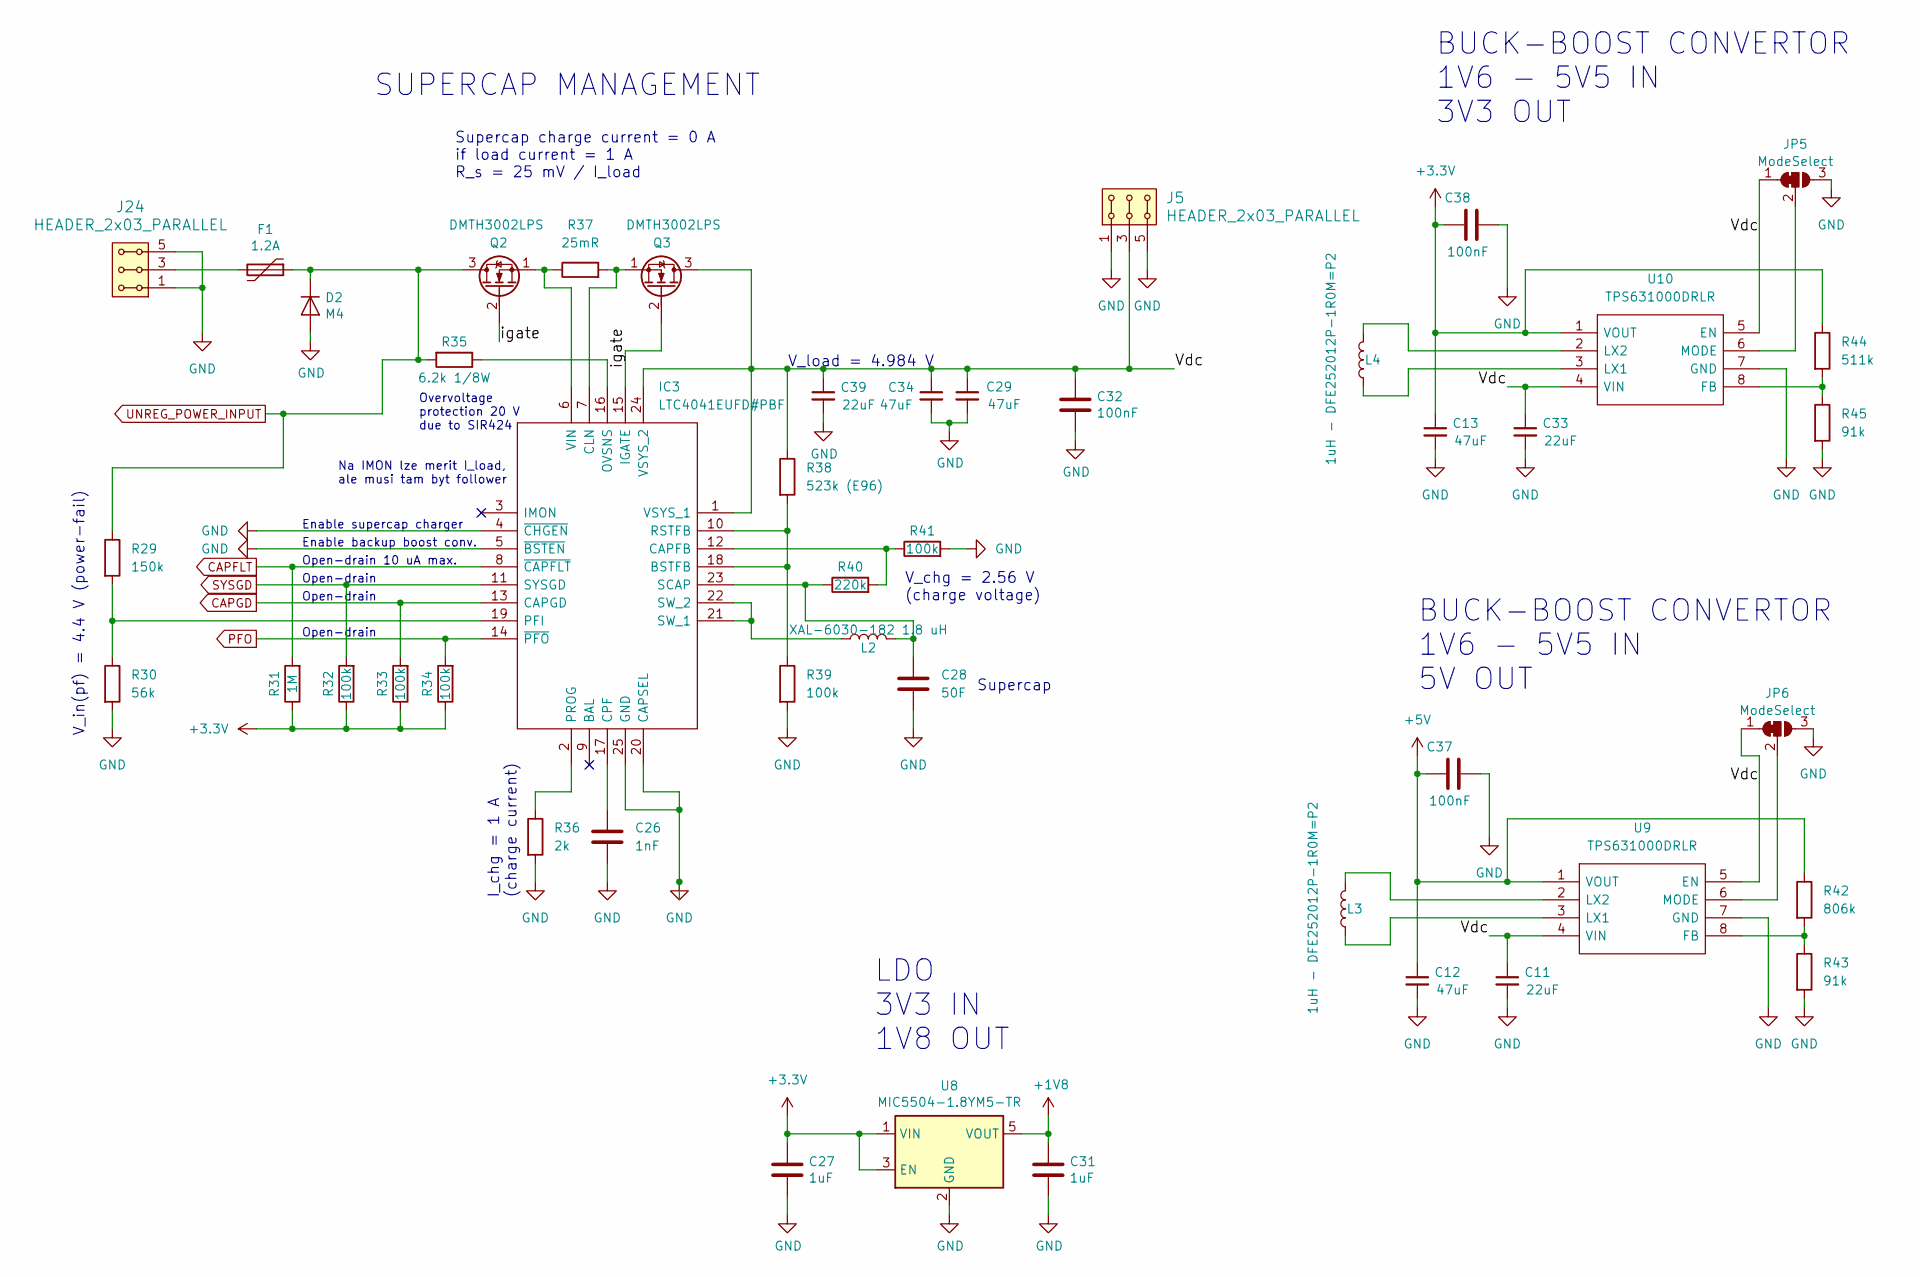
[picture p24: schematic Power_management.kicad_sch, DATALOGGER02A]

Parts:
C11, C33, C39: 22uF; C_0805_2012Metric
C12, C13, C29, C34: 47uF; C_0805_2012Metric
C26: 1nF; C_0805_2012Metric
C27, C31: 1uF; C_0805_2012Metric
C28: 50F; CP_Radial_D18.0mm_P7.50mm
C32, C37, C38: 100nF; C_0805_2012Metric
D2: M4; Diode-SMA_Standard
F1: 1.2A; 1812
IC3: LTC4041EUFD#PBF; QFN-24-1EP_4x5mm_P0.5mm_EP2.65x3.65mm; Mouser Part Number 584-4041EUFDPB
J5, J24: HEADER_2x03_PARALLEL; Straight_2x03
JP5, JP6: ModeSelect; SolderJumper-3_P1.3mm_Bridged12_RoundedPad1.0x1.5mm_NumberL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
L2: XAL-6030-182 1.8 uH; XAL6030181MEC
L3, L4: 1uH - DFE252012P-1R0M=P2; L_1008_2520Metric
Q2, Q3: DMTH3002LPS; D_POWERDI5060-8_6.0x5.1mm_P1.27mm; Manufacturer_Part_Number DMT31M7LPS-13
R29: 150k; R_0805_2012Metric
R30: 56k; R_0805_2012Metric
R31: 1M; R_0805_2012Metric
R32, R33, R34, R39, R41: 100k; R_0805_2012Metric
R35: 6.2k 1/8W; R_0805_2012Metric
R36: 2k; R_0805_2012Metric
R37: 25mR; R_0805_2012Metric
R38: 523k (E96); R_0805_2012Metric
R40: 220k; R_0805_2012Metric
R42: 806k; R_0805_2012Metric
R43, R45: 91k; R_0805_2012Metric
R44: 511k; R_0805_2012Metric
U8: MIC5504-1.8YM5-TR; SOT-23-5
U9, U10: TPS631000DRLR; SOT-583-8; Mouser Part Number 595-TPS631000DRLR

Connections:
+1V8: C31.1, U8.5 (VOUT); also elsewhere on the board
+3.3V: C13.1, C27.1, C38.1, R31.1, R32.1, R33.1, R34.1, R44.1, U8.1 (VIN), U8.3 (EN), U10.1 (VOUT); also elsewhere on the board
+5V: C12.1, C37.1, R42.1, U9.1 (VOUT); also elsewhere on the board
/Power_management/Vdc: C11.1, C29.1, C32.1, C33.1, C34.1, C39.1, IC3.1 (VSYS_1), IC3.24 (VSYS_2), J5.3, J5.4, JP5.1 (A), JP6.1 (A), Q3.3 (D), R38.1, U9.4 (VIN), U9.5 (EN), U10.4 (VIN), U10.5 (EN)
/Power_management/igate: IC3.15 (IGATE), Q2.2 (G), Q3.2 (G)
CAPFLT: IC3.8 (~CAPFLT), R31.2; also elsewhere on the board
CAPGD: IC3.13 (CAPGD), R33.2; also elsewhere on the board
GND: C11.2, C12.2, C13.2, C26.2, C27.2, C28.2, C29.2, C31.2, C32.2, C33.2, C34.2, C37.2, C38.2, C39.2, D2.2 (A), IC3.4 (~CHGEN), IC3.5 (~BSTEN), IC3.20 (CAPSEL), IC3.25 (GND), J5.1, J5.2, J5.5, J5.6, J24.1, J24.2, J24.5, J24.6, JP5.3 (B), JP6.3 (B), R30.2, R36.2, R39.2, R41.2, R43.2, R45.2, U8.2 (GND), U9.7 (GND), U10.7 (GND); also elsewhere on the board
unnamed: F1.2, J24.3, J24.4
unnamed: IC3.10 (RSTFB), IC3.18 (BSTFB), R38.2, R39.1
unnamed: IC3.12 (CAPFB), R40.2, R41.1
unnamed: IC3.7 (CLN), Q3.1 (S), R37.2
unnamed: C26.1, IC3.17 (CPF)
unnamed: IC3.16 (OVSNS), R35.1
unnamed: IC3.19 (PFI), R29.2, R30.1
unnamed: IC3.2 (PROG), R36.1
unnamed: C28.1, IC3.23 (SCAP), L2.2, R40.1
unnamed: IC3.21 (SW_1), IC3.22 (SW_2), L2.1
unnamed: IC3.6 (VIN), Q2.1 (S), R37.1
unnamed: JP5.2 (C), U10.6 (MODE)
unnamed: JP6.2 (C), U9.6 (MODE)
unnamed: R42.2, R43.1, U9.8 (FB)
unnamed: L3.1, U9.3 (LX1)
unnamed: L3.2, U9.2 (LX2)
unnamed: R44.2, R45.1, U10.8 (FB)
unnamed: L4.1, U10.3 (LX1)
unnamed: L4.2, U10.2 (LX2)
PFO: IC3.14 (~PFO), R34.2; also elsewhere on the board
SYSGD: IC3.11 (SYSGD), R32.2; also elsewhere on the board
UNREG_POWER_INPUT: D2.1 (K), F1.1, Q2.3 (D), R29.1, R35.2; also elsewhere on the board

Notes on the sheet:
Open-drain
V_chg = 2.56 V (charge voltage)
Open-drain 10 uA max.
Enable backup boost conv.
I_chg = 1 A (charge current)
Overvoltage protection 20 V due to SIR424
Supercap charge current = 0 A if load current = 1 A R_s = 25 mV / I_load
LDO 3V3 IN 1V8 OUT
BUCK-BOOST CONVERTOR 1V6 - 5V5 IN 5V OUT
Supercap
Na IMON lze merit I_load, ale musi tam byt follower
SUPERCAP MANAGEMENT
Enable supercap charger
V_load = 4.984 V
V_in(pf) = 4.4 V (power-fail)
BUCK-BOOST CONVERTOR 1V6 - 5V5 IN 3V3 OUT

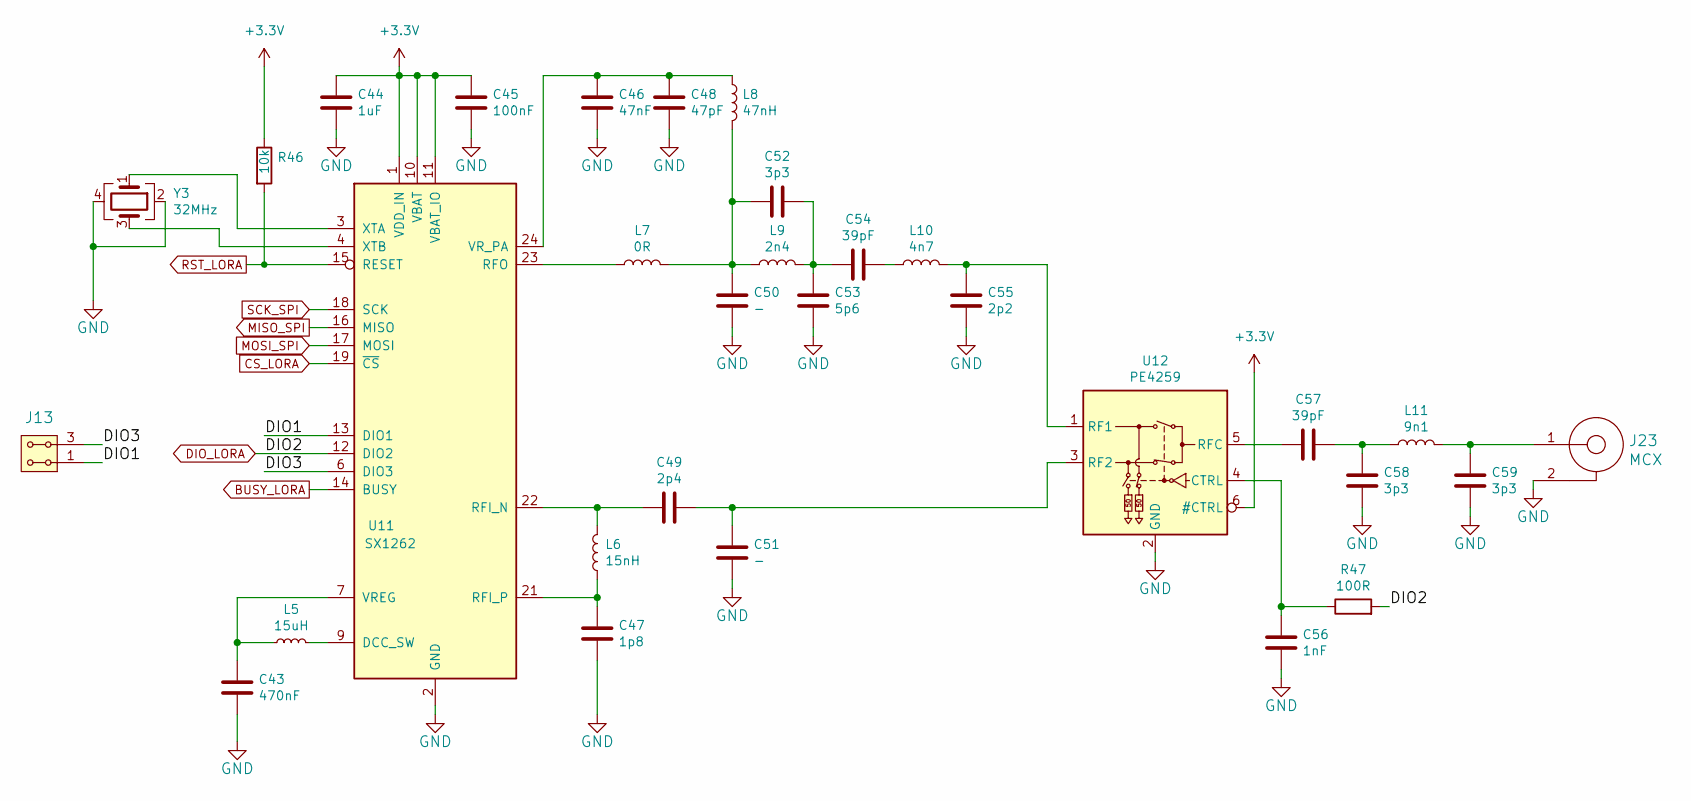
[picture p25: schematic Telemetry.kicad_sch, DATALOGGER02A]

Parts:
C43: 470nF; C_0805_2012Metric
C44: 1uF; C_0805_2012Metric
C45: 100nF; C_0805_2012Metric
C46: 47nF; C_0805_2012Metric
C47: 1p8; C_0603_1608Metric
C48: 47pF; C_0805_2012Metric
C49: 2p4; C_0603_1608Metric
C50, C51: -; C_0603_1608Metric
C52, C58, C59: 3p3; C_0603_1608Metric
C53: 5p6; C_0603_1608Metric
C54, C57: 39pF; C_0603_1608Metric
C55: 2p2; C_0603_1608Metric
C56: 1nF; C_0805_2012Metric
J13: HEADER_2x02_PARALLEL; Straight_2x02
J23: MCX
L5: 15uH; L_0805_2012Metric
L6: 15nH; L_0603_1608Metric
L7: 0R; L_0603_1608Metric
L8: 47nH; L_0603_1608Metric
L9: 2n4; L_0603_1608Metric
L10: 4n7; L_0603_1608Metric
L11: 9n1; L_0603_1608Metric
R46: 10k; R_0805_2012Metric
R47: 100R; R_0805_2012Metric
U11: SX1262; QFN-24-1EP_4x4mm_P0.5mm_EP2.6x2.6mm_ThermalVias
U12: PE4259; SOT-363_SC-70-6
Y3: 32MHz; Crystal_SMD_NX2016SA

Connections:
+3.3V: C44.1, C45.1, R46.1, U11.1 (VDD_IN), U11.10 (VBAT), U11.11 (VBAT_IO), U12.6 (#CTRL); also elsewhere on the board
/Telemetry/DIO1: J13.1, J13.2, U11.13 (DIO1)
/Telemetry/DIO3: J13.3, J13.4, U11.6 (DIO3)
BUSY_LORA: U11.14 (BUSY); also elsewhere on the board
CS_LORA: U11.19 (~CS); also elsewhere on the board
DIO_LORA: R47.2, U11.12 (DIO2); also elsewhere on the board
GND: C43.2, C44.2, C45.2, C46.2, C47.2, C48.2, C50.2, C51.2, C53.2, C55.2, C56.2, C58.1, C59.1, J23.2, U11.2 (GND), U11.5 (GND), U11.8 (GND), U11.20 (GND), U11.25 (GND), U12.2 (GND), Y3.2, Y3.4; also elsewhere on the board
MISO_SPI: U11.16 (MISO); also elsewhere on the board
MOSI_SPI: U11.17 (MOSI); also elsewhere on the board
unnamed: C50.1, C52.2, L7.2, L8.2, L9.1
unnamed: C52.1, C53.1, C54.2, L9.2
unnamed: C54.1, L10.1
unnamed: C57.1, C58.2, L11.1
unnamed: C59.2, J23.1, L11.2
unnamed: L5.2, U11.9 (DCC_SW)
unnamed: C49.2, L6.2, U11.22 (RFI_N)
unnamed: C47.1, L6.1, U11.21 (RFI_P)
unnamed: L7.1, U11.23 (RFO)
unnamed: C43.1, L5.1, U11.7 (VREG)
unnamed: C46.1, C48.1, L8.1, U11.24 (VR_PA)
unnamed: U11.3 (XTA), Y3.1
unnamed: U11.4 (XTB), Y3.3
unnamed: C56.1, R47.1, U12.4 (CTRL)
unnamed: C55.1, L10.2, U12.1 (RF1)
unnamed: C49.1, C51.1, U12.3 (RF2)
unnamed: C57.2, U12.5 (RFC)
RST_LORA: R46.2, U11.15 (RESET); also elsewhere on the board
SCK_SPI: U11.18 (SCK); also elsewhere on the board

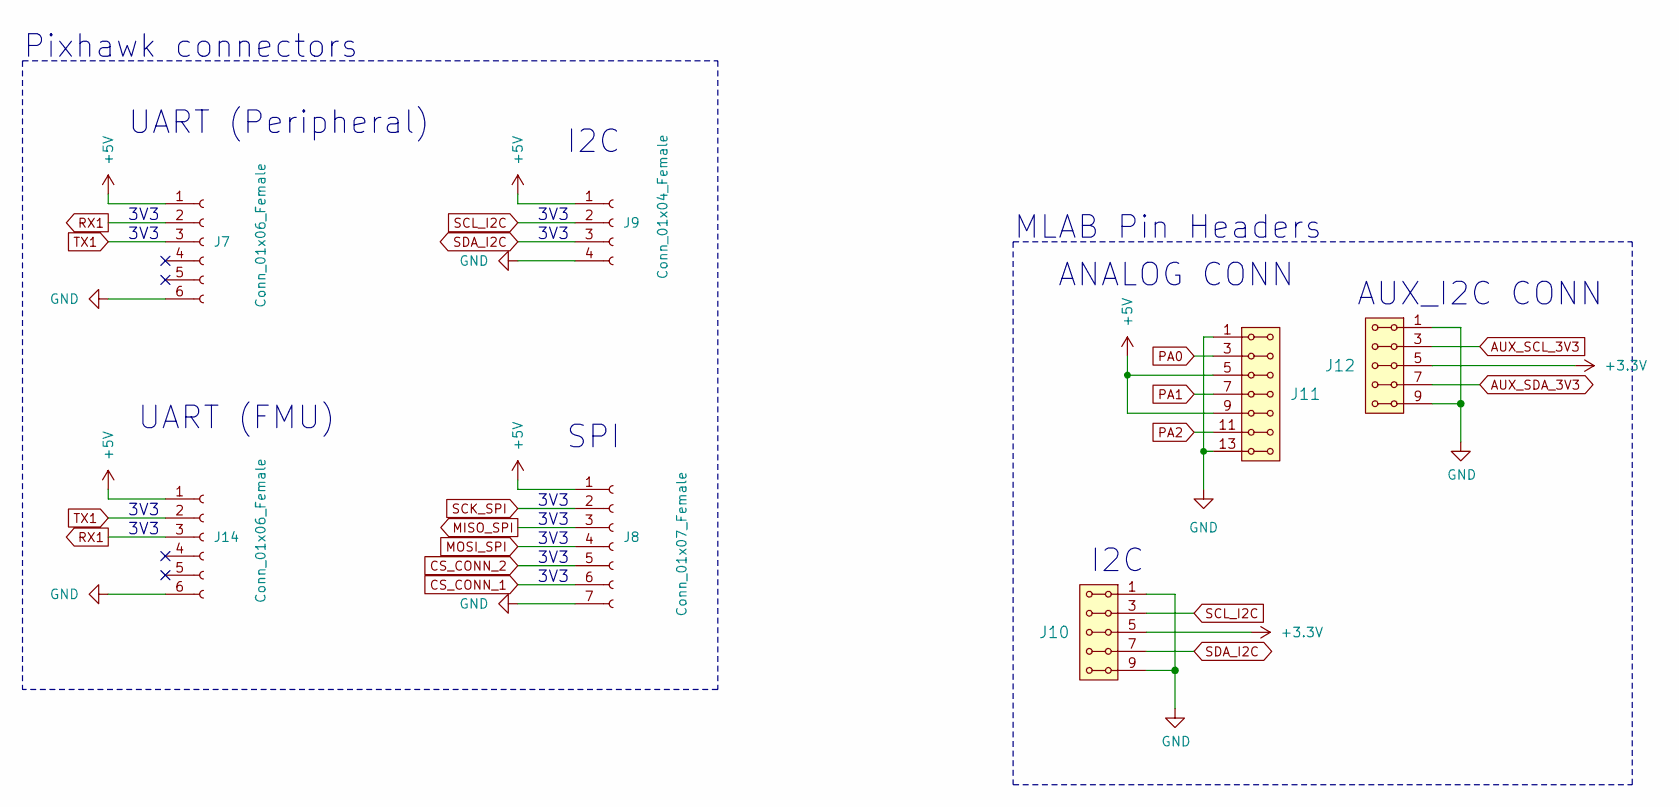
[picture p26: schematic Connectors.kicad_sch, DATALOGGER02A]

Parts:
J7, J14: Conn_01x06_Female; JST_GH_SM06B-GHS-TB_1x06-1MP_P1.25mm_Horizontal
J8: Conn_01x07_Female; JST_GH_SM07B-GHS-TB_1x07-1MP_P1.25mm_Horizontal
J9: Conn_01x04_Female; JST_GH_SM04B-GHS-TB_1x04-1MP_P1.25mm_Horizontal
J10, J12: HEADER_2x05_PARALLEL; Straight_2x05
J11: HEADER_2x07_PARALLEL; Straight_2x07

Connections:
+3.3V: J10.5, J10.6, J12.5, J12.6; also elsewhere on the board
+5V: J7.1, J8.1, J9.1, J11.5, J11.6, J11.9, J11.10, J14.1; also elsewhere on the board
AUX_SCL_3V3: J12.3, J12.4; also elsewhere on the board
AUX_SDA_3V3: J12.7, J12.8; also elsewhere on the board
CS_CONN_1: J8.6; also elsewhere on the board
CS_CONN_2: J8.5; also elsewhere on the board
GND: J7.6, J8.7, J9.4, J10.1, J10.2, J10.9, J10.10, J11.1, J11.2, J11.13, J11.14, J12.1, J12.2, J12.9, J12.10, J14.6; also elsewhere on the board
MISO_SPI: J8.3; also elsewhere on the board
MOSI_SPI: J8.4; also elsewhere on the board
PA0: J11.3, J11.4; also elsewhere on the board
PA1: J11.7, J11.8; also elsewhere on the board
PA2: J11.11, J11.12; also elsewhere on the board
RX1: J7.2, J14.3; also elsewhere on the board
SCK_SPI: J8.2; also elsewhere on the board
SCL_I2C: J9.2, J10.3, J10.4; also elsewhere on the board
SDA_I2C: J9.3, J10.7, J10.8; also elsewhere on the board
TX1: J7.3, J14.2; also elsewhere on the board

Notes on the sheet:
3V3
ANALOG CONN
I2C
AUX_I2C CONN
MLAB Pin Headers
UART (FMU)
SPI
UART (Peripheral)
Pixhawk connectors

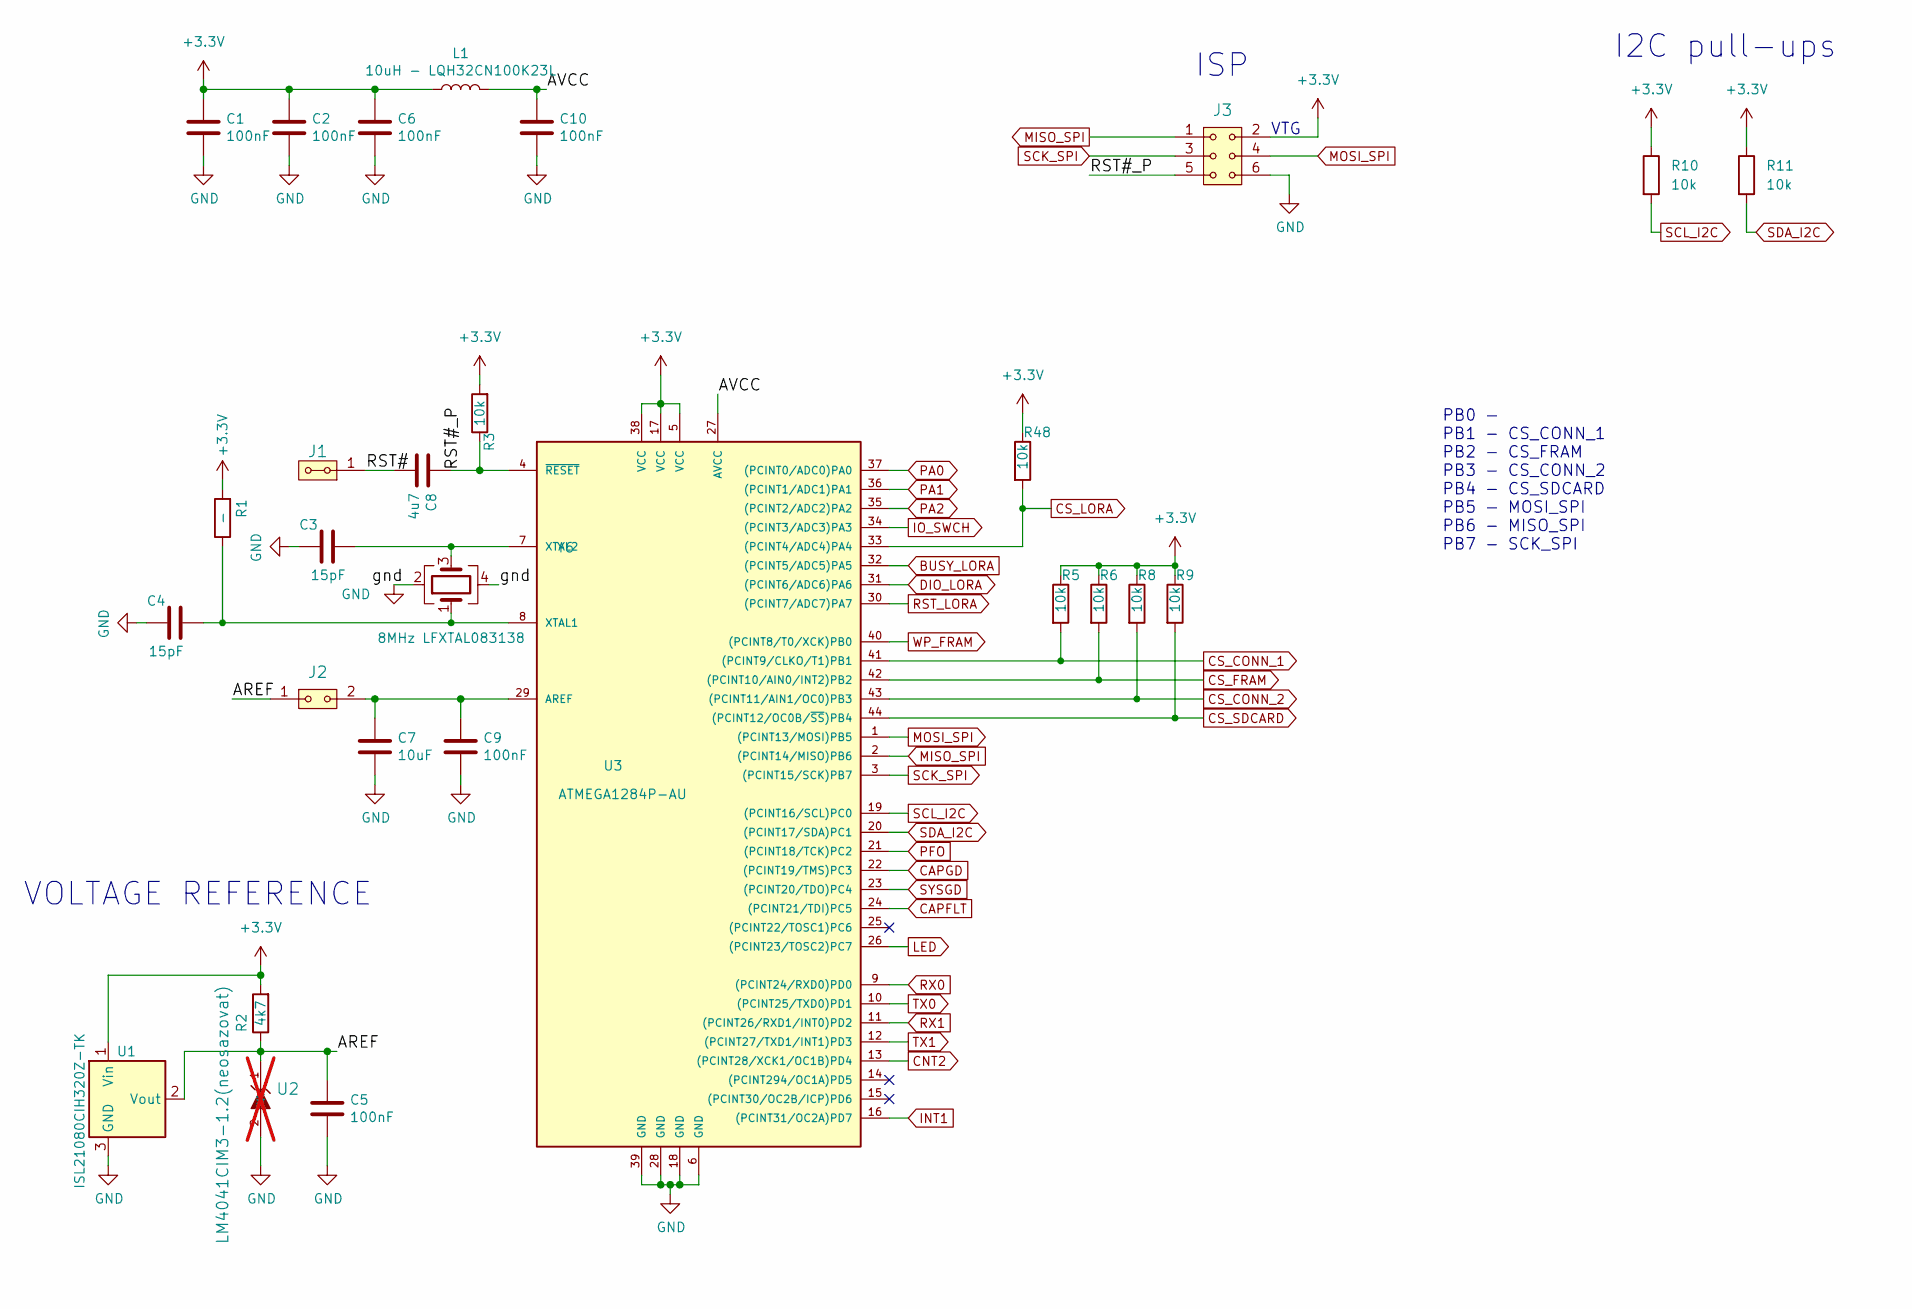
[picture p27: schematic Microcontroller.kicad_sch, DATALOGGER02A]

Parts:
C1, C2, C5, C6, C9, C10: 100nF; C_0805_2012Metric
C3, C4: 15pF; C_0805_2012Metric
C7: 10uF; C_0805_2012Metric
C8: 4u7; C_0805_2012Metric
J1: HEADER_2x01_PARALLEL; Straight_2x01
J2: HEADER_2x01; Straight_2x01
J3: HEADER_2x03; SMD_2x03_WO_paste
L1: 10uH - LQH32CN100K23L; SMD-1210
R1: -; R_0805_2012Metric
R2: 4k7; R_0805_2012Metric
R3, R5, R6, R8, R9, R10, R11, R48: 10k; R_0805_2012Metric
U1: ISL21080CIH320Z-TK; SOT-23
U2: LM4041CIM3-1.2(neosazovat); SOT-23; not fitted
U3: ATMEGA1284P-AU; TQFP-44_10x10mm_P0.8mm
Y6: 8MHz LFXTAL083138; Crystal SMD CFPX-180

Connections:
+3.3V: C1.1, C2.1, C6.1, J3.2, L1.1, R1.2, R2.2, R3.2, R5.1, R6.1, R8.1, R9.1, R10.1, R11.1, R48.1, U1.1 (Vin), U3.5 (VCC), U3.17 (VCC), U3.38 (VCC); also elsewhere on the board
/Microcontroller/AREF: C5.1, J2.1, R2.1, U1.2 (Vout), U2.1 (K)
/Microcontroller/AVCC: C10.1, L1.2, U3.27 (AVCC)
/Microcontroller/RST#: C8.2, J1.1, J1.2
/Microcontroller/RST#_P: C8.1, J3.5, R3.1, U3.4 (~RESET)
BUSY_LORA: U3.32 ((PCINT5/ADC5)PA5); also elsewhere on the board
CAPFLT: U3.24 ((PCINT21/TDI)PC5); also elsewhere on the board
CAPGD: U3.22 ((PCINT19/TMS)PC3); also elsewhere on the board
CNT2: U3.13 ((PCINT28/XCK1/OC1B)PD4); also elsewhere on the board
CS_CONN_1: R5.2, U3.41 ((PCINT9/CLKO/T1)PB1); also elsewhere on the board
CS_CONN_2: R8.2, U3.43 ((PCINT11/AIN1/OC0)PB3); also elsewhere on the board
CS_FRAM: R6.2, U3.42 ((PCINT10/AIN0/INT2)PB2); also elsewhere on the board
CS_LORA: R48.2, U3.33 ((PCINT4/ADC4)PA4); also elsewhere on the board
CS_SDCARD: R9.2, U3.44 ((PCINT12/OC0B/~SS)PB4); also elsewhere on the board
DIO_LORA: U3.31 ((PCINT6/ADC6)PA6); also elsewhere on the board
GND: C1.2, C2.2, C3.1, C4.1, C5.2, C6.2, C7.2, C9.2, C10.2, J3.6, U1.3 (GND), U2.2 (A), U3.6 (GND), U3.18 (GND), U3.28 (GND), U3.39 (GND), Y6.2, Y6.4; also elsewhere on the board
INT1: U3.16 ((PCINT31/OC2A)PD7); also elsewhere on the board
IO_SWCH: U3.34 ((PCINT3/ADC3)PA3); also elsewhere on the board
LED: U3.26 ((PCINT23/TOSC2)PC7); also elsewhere on the board
MISO_SPI: J3.1, U3.2 ((PCINT14/MISO)PB6); also elsewhere on the board
MOSI_SPI: J3.4, U3.1 ((PCINT13/MOSI)PB5); also elsewhere on the board
unnamed: C7.1, C9.1, J2.2, U3.29 (AREF)
unnamed: C4.2, R1.1, U3.8 (XTAL1), Y6.1
unnamed: C3.2, U3.7 (XTAL2), Y6.3
PA0: U3.37 ((PCINT0/ADC0)PA0); also elsewhere on the board
PA1: U3.36 ((PCINT1/ADC1)PA1); also elsewhere on the board
PA2: U3.35 ((PCINT2/ADC2)PA2); also elsewhere on the board
PFO: U3.21 ((PCINT18/TCK)PC2); also elsewhere on the board
RST_LORA: U3.30 ((PCINT7/ADC7)PA7); also elsewhere on the board
RX0: U3.9 ((PCINT24/RXD0)PD0)
RX1: U3.11 ((PCINT26/RXD1/INT0)PD2); also elsewhere on the board
SCK_SPI: J3.3, U3.3 ((PCINT15/SCK)PB7); also elsewhere on the board
SCL_I2C: R10.2, U3.19 ((PCINT16/SCL)PC0); also elsewhere on the board
SDA_I2C: R11.2, U3.20 ((PCINT17/SDA)PC1); also elsewhere on the board
SYSGD: U3.23 ((PCINT20/TDO)PC4); also elsewhere on the board
TX0: U3.10 ((PCINT25/TXD0)PD1)
TX1: U3.12 ((PCINT27/TXD1/INT1)PD3); also elsewhere on the board
WP_FRAM: U3.40 ((PCINT8/T0/XCK)PB0); also elsewhere on the board

Notes on the sheet:
VOLTAGE REFERENCE
I2C pull-ups
ISP
VTG
PB0 - PB1 - CS_CONN_1 PB2 - CS_FRAM PB3 - CS_CONN_2 PB4 - CS_SDCARD PB5 - MOSI_SPI PB6 - MISO_SPI PB7 - SCK_SPI

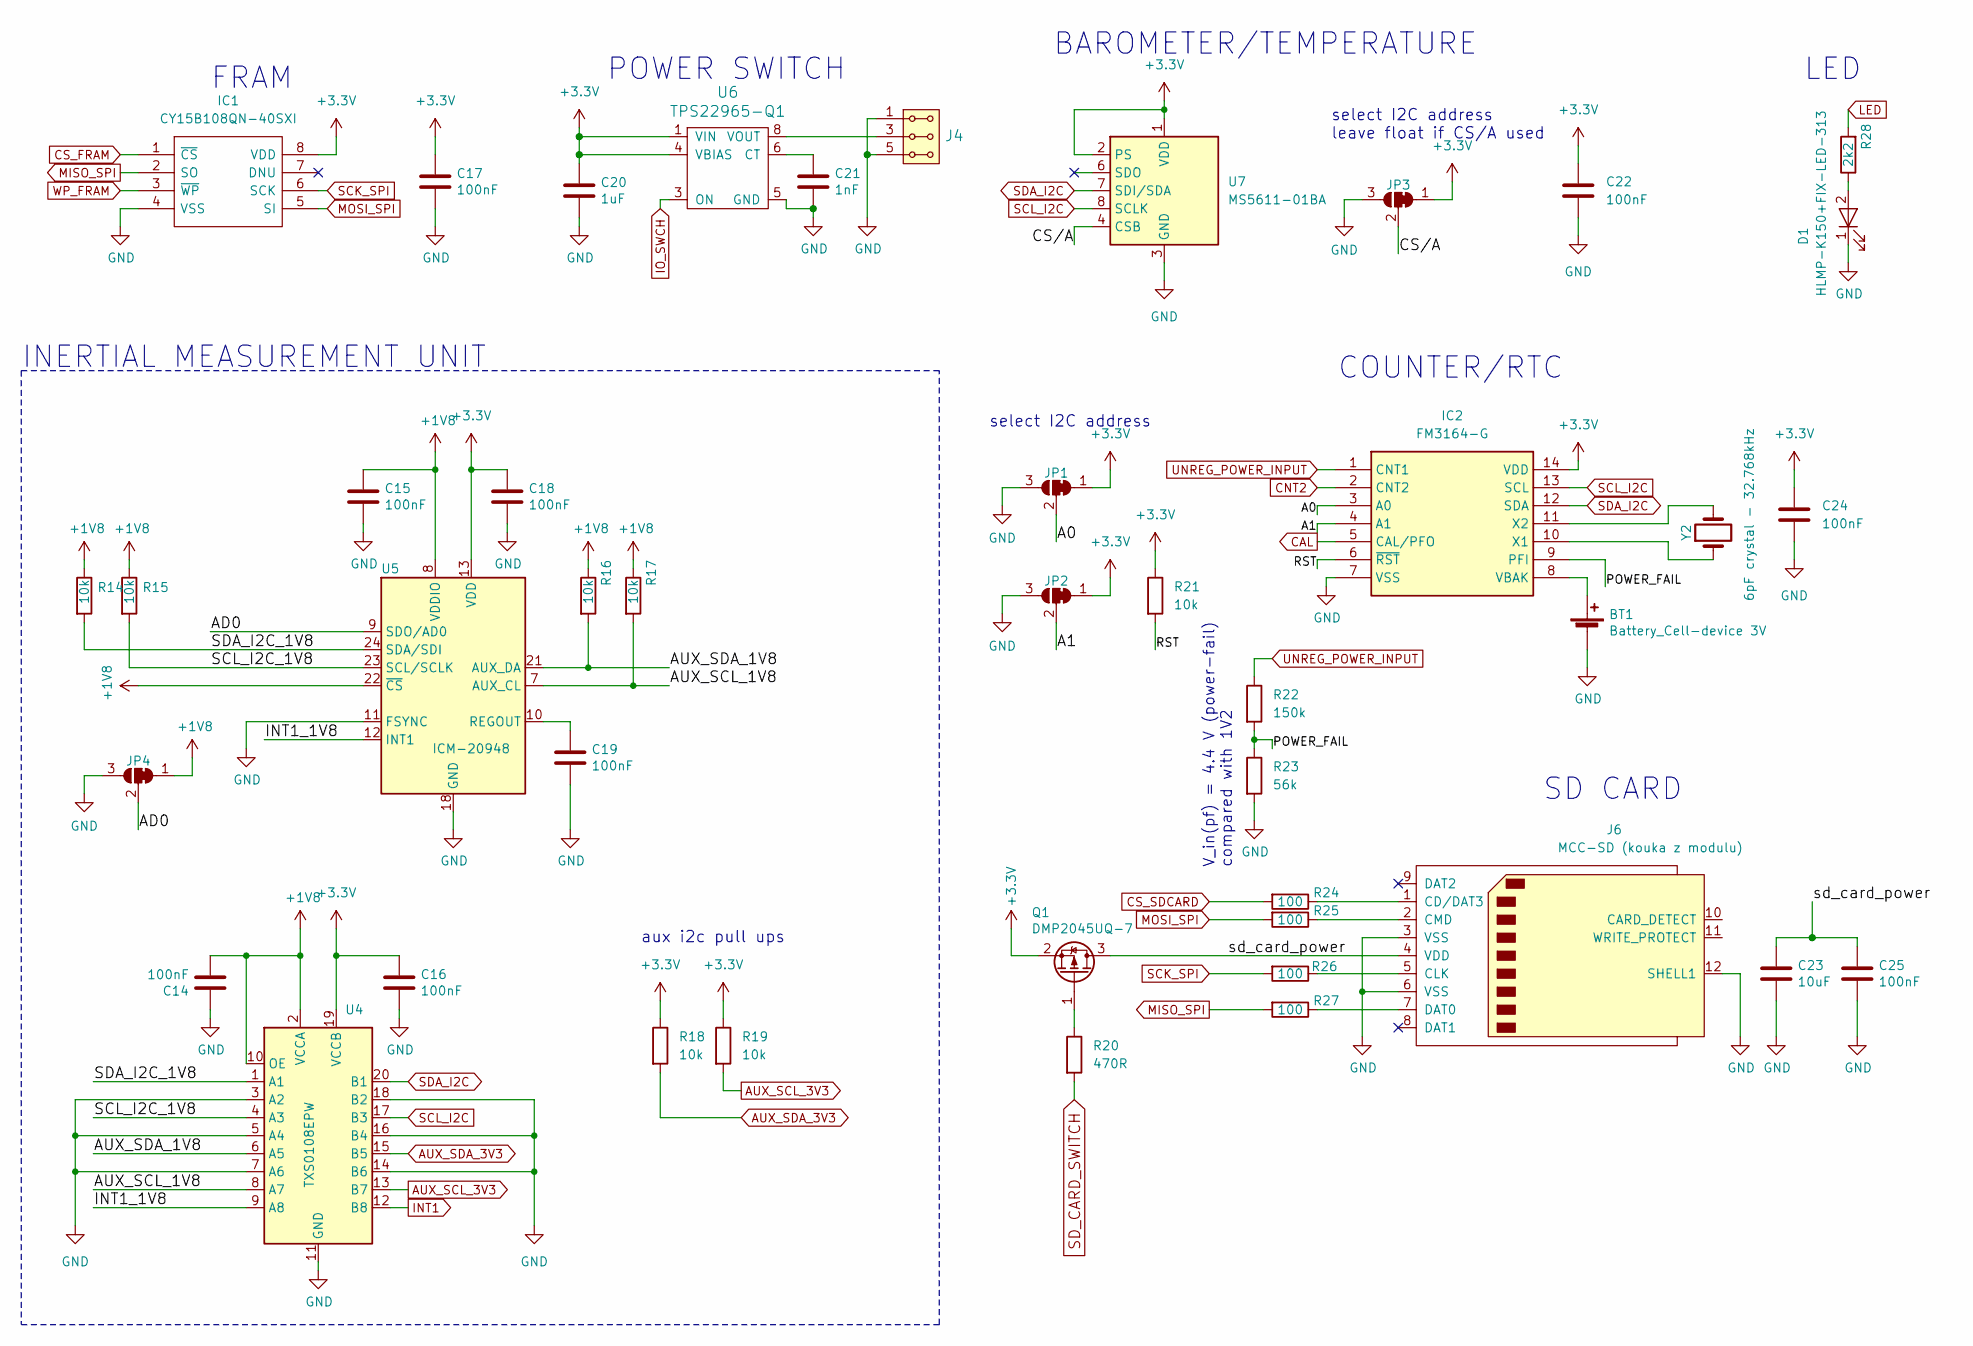
[picture p28: schematic Peripherals.kicad_sch, DATALOGGER02A]

Parts:
BT1: Battery_Cell-device 3V; BatteryHolder_Keystone_2998_1x6.8mm
C14, C15, C16, C17, C18, C19, C22, C24, C25: 100nF; C_0805_2012Metric
C20: 1uF; C_0805_2012Metric
C21: 1nF; C_0805_2012Metric
C23: 10uF; C_0805_2012Metric
D1: HLMP-K150+FIX-LED-313; LED_1206_mill
IC1: CY15B108QN-40SXI; SOIC-8_3.9x4.9mm_Pitch1.27mm; Mouser Part Number 727-CY15B108QN-40SXI
IC2: FM3164-G; SOIC-14_3.9x8.7mm_P1.27mm; Manufacturer_Part_Number FM3164-S
J4: HEADER_2x03_PARALLEL; Straight_2x03
J6: MCC-SD (kouka z modulu); MCC-SD
JP1, JP2, JP3, JP4: SolderJumper_3_Bridged12; SolderJumper-3_P1.3mm_Bridged12_RoundedPad1.0x1.5mm_NumberL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
Q1: DMP2045UQ-7; SOT-23
R14, R15, R16, R17, R18, R19, R21: 10k; R_0805_2012Metric
R20: 470R; R_0805_2012Metric
R22: 150k; R_0805_2012Metric
R23: 56k; R_0805_2012Metric
R24, R25, R26, R27: 100; R_0805_2012Metric
R28: 2k2; R_0805_2012Metric
U4: TXS0108EPW; TSSOP-20_4.4x6.5mm_P0.65mm
U5: ICM-20948; InvenSense_QFN-24_3x3mm_P0.4mm
U6: TPS22965-Q1; WSON-8-1EP_2x2mm_P0.5mm_EP0.9x1.6mm_ThermalVias
U7: MS5611-01BA; LGA-8_3x5mm_P1.25mm
Y2: 6pF crystal - 32.768kHz; ABS07

Connections:
+1V8: C14.2, C15.1, JP4.1 (A), R14.1, R15.1, R16.1, R17.1, U4.2 (VCCA), U4.10 (OE), U5.8 (VDDIO), U5.22 (~CS); also elsewhere on the board
+3.3V: C16.1, C17.1, C18.1, C20.1, C22.1, C24.1, IC1.8 (VDD), IC2.14 (VDD), JP1.1 (A), JP2.1 (A), JP3.1 (A), Q1.2 (S), R18.1, R19.1, R21.1, U4.19 (VCCB), U5.13 (VDD), U6.1 (VIN), U6.2 (VIN), U6.4 (VBIAS), U7.1 (VDD), U7.2 (PS); also elsewhere on the board
/Peripherals/A0: IC2.3 (A0), JP1.2 (C)
/Peripherals/A1: IC2.4 (A1), JP2.2 (C)
/Peripherals/AD0: JP4.2 (C), U5.9 (SDO/AD0)
/Peripherals/AUX_SCL_1V8: R17.2, U4.8 (A7), U5.7 (AUX_CL)
/Peripherals/AUX_SDA_1V8: R16.2, U4.6 (A5), U5.21 (AUX_DA)
/Peripherals/CS/A: JP3.2 (C), U7.4 (CSB), U7.5 (CSB)
/Peripherals/INT1_1V8: U4.9 (A8), U5.12 (INT1)
/Peripherals/POWER_FAIL: IC2.9 (PFI), R22.2, R23.1
/Peripherals/RST: IC2.6 (~RST), R21.2
/Peripherals/SCL_I2C_1V8: R15.2, U4.4 (A3), U5.23 (SCL/SCLK)
/Peripherals/SDA_I2C_1V8: R14.2, U4.1 (A1), U5.24 (SDA/SDI)
/Peripherals/sd_card_power: C23.1, C25.1, J6.4 (VDD), Q1.3 (D)
AUX_SCL_3V3: R19.2, U4.13 (B7); also elsewhere on the board
AUX_SDA_3V3: R18.2, U4.15 (B5); also elsewhere on the board
CAL: IC2.5 (CAL/PFO)
CNT2: IC2.2 (CNT2); also elsewhere on the board
CS_FRAM: IC1.1 (~CS); also elsewhere on the board
CS_SDCARD: R24.2; also elsewhere on the board
GND: BT1.2 (-), C14.1, C15.2, C16.2, C17.2, C18.2, C19.2, C20.2, C21.2, C22.2, C23.2, C24.2, C25.2, D1.1 (K), IC1.4 (VSS), IC2.7 (VSS), J4.1, J4.2, J4.5, J4.6, J6.3 (VSS), J6.6 (VSS), J6.12 (SHELL1), JP1.3 (B), JP2.3 (B), JP3.3 (B), JP4.3 (B), R23.2, U4.3 (A2), U4.5 (A4), U4.7 (A6), U4.11 (GND), U4.14 (B6), U4.16 (B4), U4.18 (B2), U5.11 (FSYNC), U5.18 (GND), U5.20 (GND), U6.5 (GND), U6.9, U7.3 (GND); also elsewhere on the board
INT1: U4.12 (B8); also elsewhere on the board
IO_SWCH: U6.3 (ON); also elsewhere on the board
LED: R28.2; also elsewhere on the board
MISO_SPI: IC1.2 (SO), R27.2; also elsewhere on the board
MOSI_SPI: IC1.5 (SI), R25.2; also elsewhere on the board
unnamed: BT1.1 (+), IC2.8 (VBAK)
unnamed: D1.2 (A), R28.1
unnamed: IC2.10 (X1), Y2.1
unnamed: IC2.11 (X2), Y2.2
unnamed: J4.3, J4.4, U6.7 (VOUT), U6.8 (VOUT)
unnamed: J6.1 (CD/DAT3), R24.1
unnamed: J6.5 (CLK), R26.1
unnamed: J6.2 (CMD), R25.1
unnamed: J6.7 (DAT0), R27.1
unnamed: Q1.1 (G), R20.1
unnamed: C19.1, U5.10 (REGOUT)
unnamed: C21.1, U6.6 (CT)
SCK_SPI: IC1.6 (SCK), R26.2; also elsewhere on the board
SCL_I2C: IC2.13 (SCL), U4.17 (B3), U7.8 (SCLK); also elsewhere on the board
SDA_I2C: IC2.12 (SDA), U4.20 (B1), U7.7 (SDI/SDA); also elsewhere on the board
SD_CARD_SWITCH: R20.2
UNREG_POWER_INPUT: IC2.1 (CNT1), R22.1; also elsewhere on the board
WP_FRAM: IC1.3 (~WP); also elsewhere on the board

Notes on the sheet:
select I2C address
POWER SWITCH
COUNTER/RTC
INERTIAL MEASUREMENT UNIT
FRAM
V_in(pf) = 4.4 V (power-fail) compared with 1V2
SD CARD
aux i2c pull ups
BAROMETER/TEMPERATURE
select I2C address leave float if CS/A used
LED

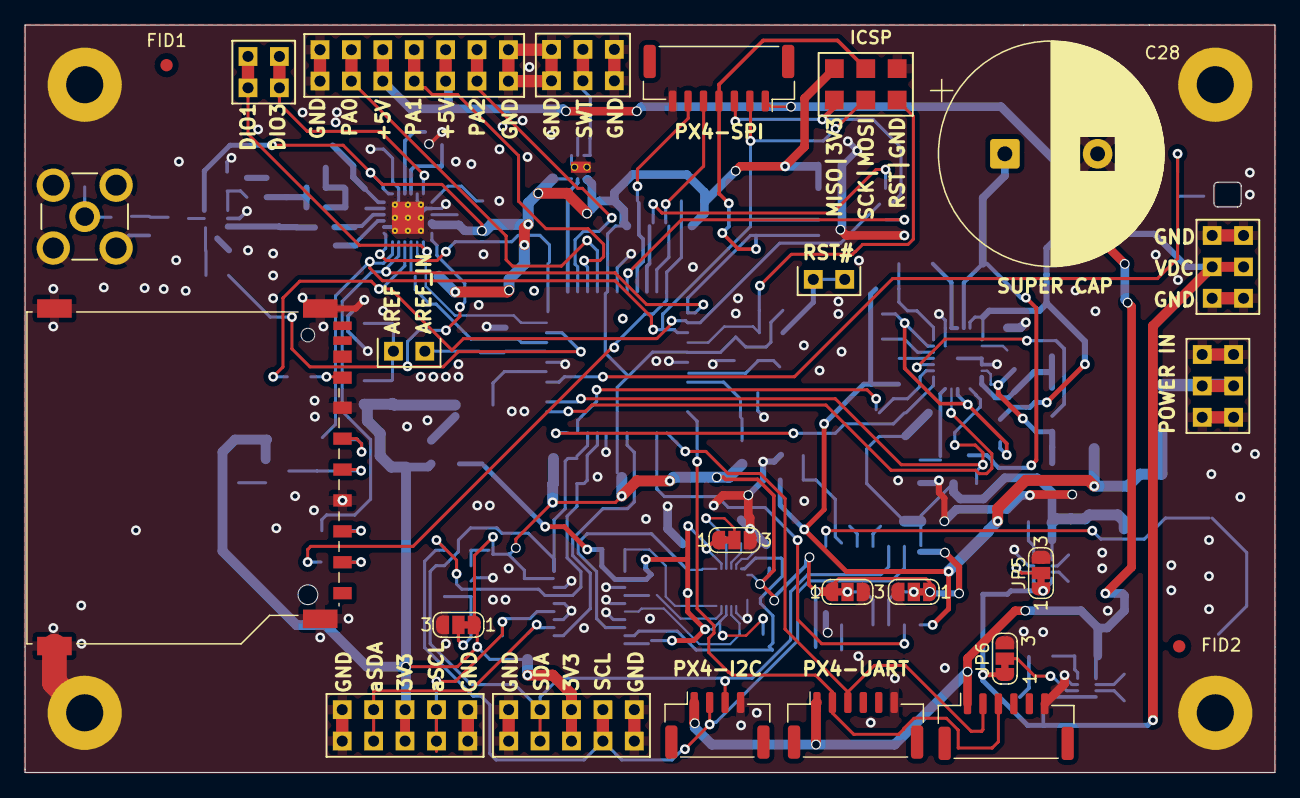
[picture p29: board DATALOGGER02.kicad_pcb from above]

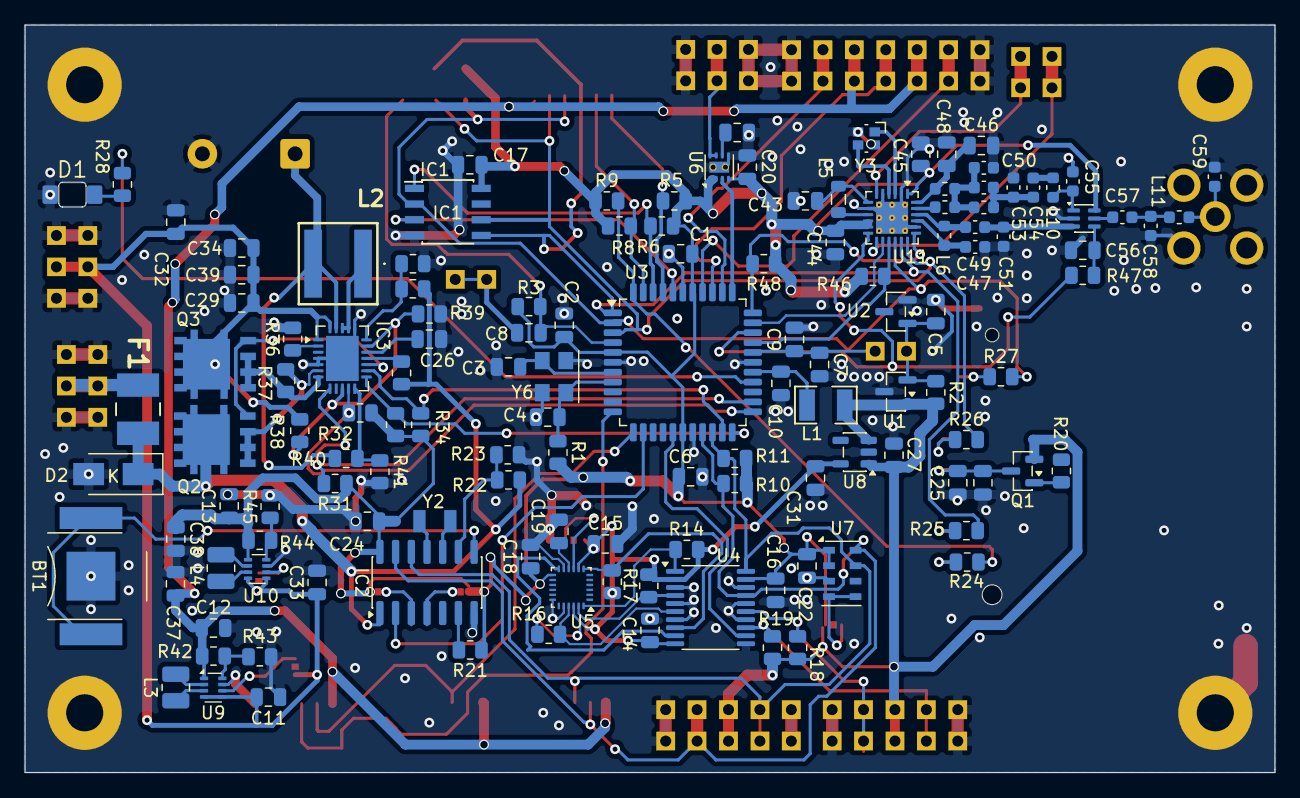
[picture p30: board DATALOGGER02.kicad_pcb from below]

Board: 2 copper layers, 101.1 x 60.5 mm, 161 parts (132 on the bottom side), 105 nets.
