mlab-modules/DATALOGGER02/(commit log)

2025-09-06 Update project to KiCADv9.
    [Connectors.kicad_sch, DATALOGGER02.kicad_pcb, DATALOGGER02.kicad_sch, Microcontroller.kicad_sch, Peripherals.kicad_sch, Power_management.kicad_sch, Telemetry.kicad_sch]
2025-09-06 Update actions products
    [DATALOGGER02-B_Cu.dxf, DATALOGGER02-B_Mask.dxf, DATALOGGER02-B_Silkscreen.dxf, DATALOGGER02-F_Courtyard.dxf, DATALOGGER02-F_Cu.dxf, DATALOGGER02-F_Fab.dxf, DATALOGGER02-F_Mask.dxf, DATALOGGER02-F_Silkscreen.dxf]
2026-01-18 Desing improvements WIP.
    [Connectors.kicad_sch, DATALOGGER02.kicad_pcb, Microcontroller.kicad_sch]
2026-07-24 úprava návrhu PCB
    [Connectors.kicad_sch, DATALOGGER02.kicad_pcb, DATALOGGER02.kicad_sch, Microcontroller.kicad_sch, Peripherals.kicad_sch, Power_management.kicad_sch, Telemetry.kicad_sch]
2026-08-02 small changes in PCB layout
    [DATALOGGER02.kicad_pcb]
2026-08-03 Minor layout improvements.
    [DATALOGGER02.kicad_pcb]
2026-08-03 Update submodule and KiCAD workflow.
2026-08-03 csv list of material created
    [DATALOGGER02.csv, DATALOGGER02.kicad_pcb]
2026-08-03 track width changes
    [DATALOGGER02.kicad_pcb]
2026-08-09 Automatic update of KiCAD outputs
    [DATALOGGER02-B_Adhesive.dxf, DATALOGGER02-B_Courtyard.dxf, DATALOGGER02-B_Cu.dxf, DATALOGGER02-B_Fab.dxf, DATALOGGER02-B_Mask.dxf, DATALOGGER02-B_Paste.dxf, DATALOGGER02-B_Silkscreen.dxf, DATALOGGER02-Edge_Cuts.dxf]
2026-08-09 Update footprints. Run DRC check.
    [DATALOGGER02.kicad_pcb]
2026-08-09 Add JLCPCB design rules file.
    [DATALOGGER02.kicad_pcb]
2026-08-14 minor pcb layout fixes
    [DATALOGGER02.kicad_pcb]
