mlab-modules/DATALOGGER02/(notices)

Notices in the files:
hw/sch_pcb/DATALOGGER02.kicad_pcb:
GPL 3.0
